Vertex3dPrinters/VERTEX-XL/README.md

# VertexXL
VertexXL printed parts

In this repository you will be able to find all the STL files ready to print and STEP files
