Vertex3dPrinters/VERTEX-XL/STEP/ELECTRONICS/XL PCB.png

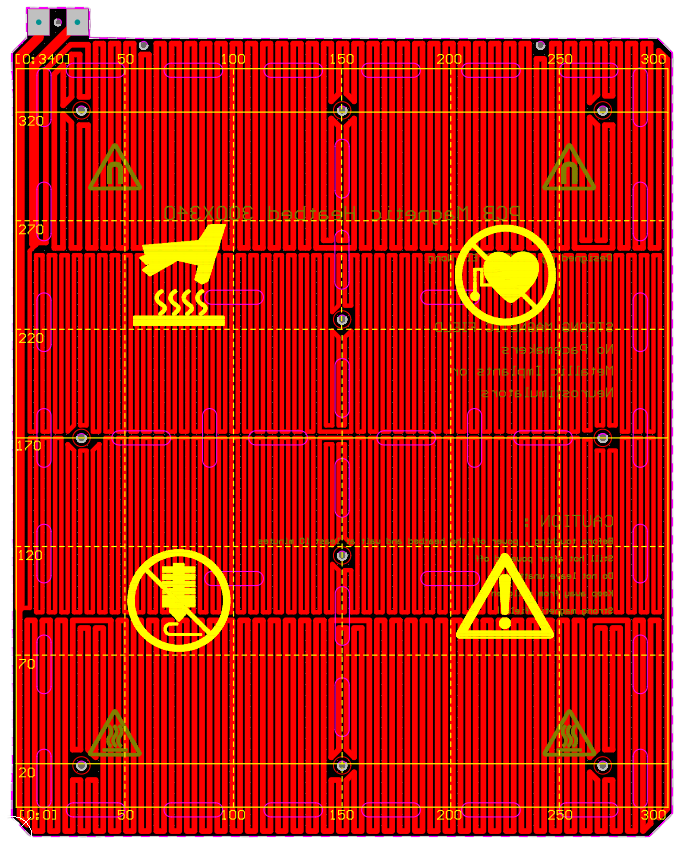
STEP/ELECTRONICS/XL PCB.png
