Vertex3dPrinters/VERTEX-XL/STL/LCD/MMU VERSION/LCD_cover_main_color.stl

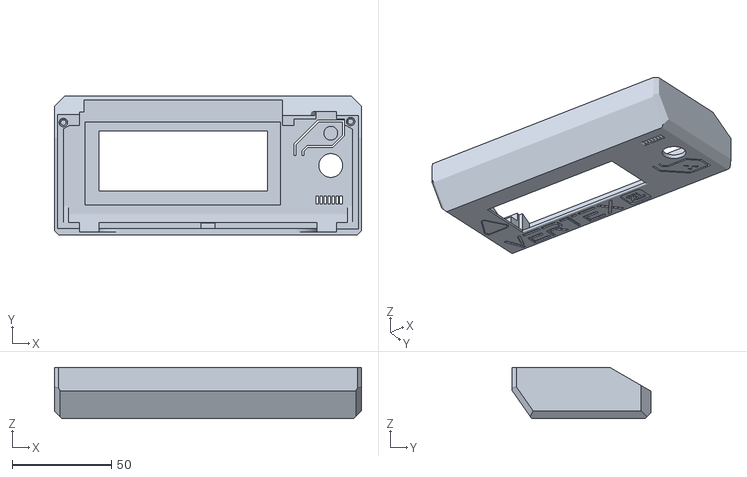
[picture p2: CAD file, 2021-08-20]
STL/LCD/MMU VERSION/LCD_cover_main_color.stl
155.0 x 70.0 x 26.0
