Vertex3dPrinters/VERTEX-XL/PS model/STL/xl_bed.stl

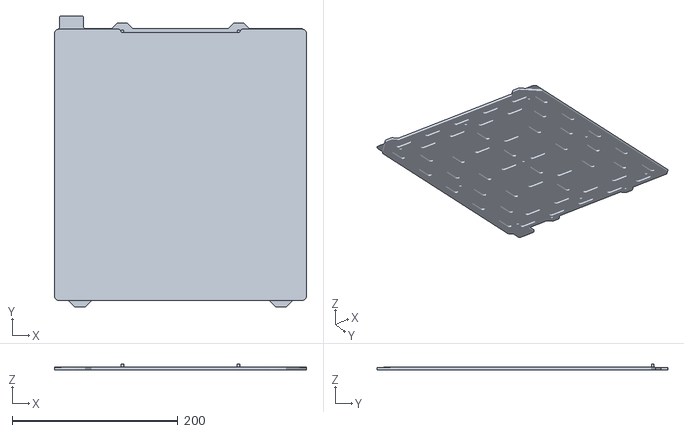
[picture p3: CAD file, 2022-12-13]
PS model/STL/xl_bed.stl
304.0 x 351.0 x 7.00
