Vertex3dPrinters/VERTEX-XL/STEP/ACCESORIES/ALUMINIUM_PROFILES.step

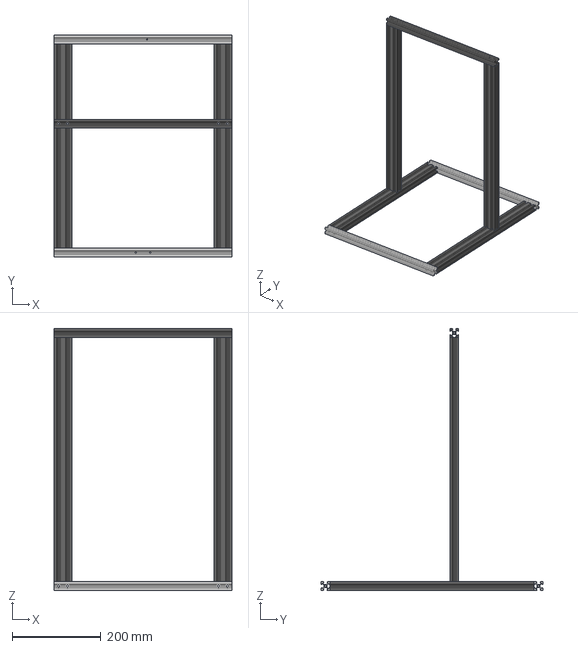
[picture p4: CAD file, 2021-09-25]
STEP/ACCESORIES/ALUMINIUM_PROFILES.step
400.0 x 500.0 x 590.0 mm
