Vertex3dPrinters/VERTEX-XL/STEP/ELECTRONICS/LCD_SINGLE.step

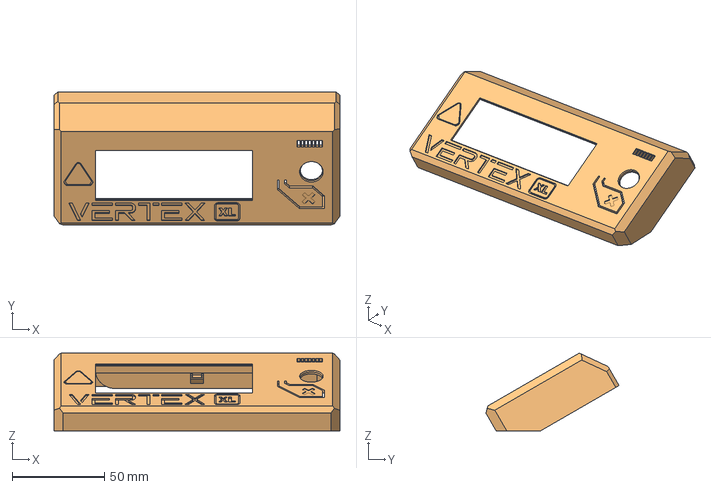
[picture p5: CAD file, 2021-09-25]
STEP/ELECTRONICS/LCD_SINGLE.step
155.0 x 72.2 x 42.2 mm
