Vertex3dPrinters/VERTEX-XL/STEP/X AXIS/EXTRUDERS/extruder-body.step

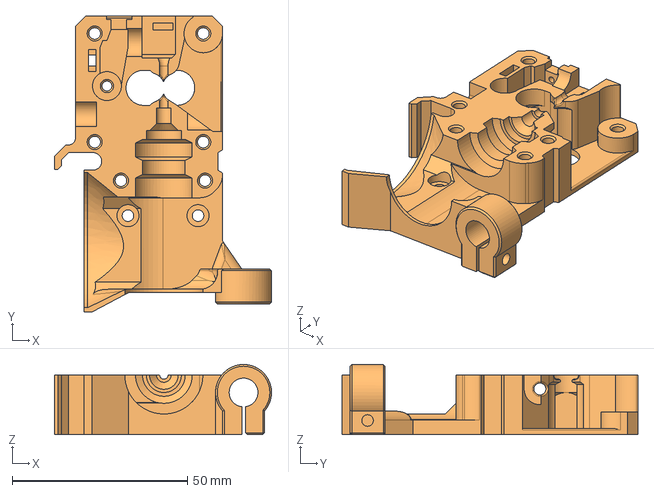
[picture p6: CAD file, 2021-09-27]
STEP/X AXIS/EXTRUDERS/extruder-body.step
62.0 x 84.5 x 20.0 mm
