Vertex3dPrinters/VERTEX-XL/STEP/X AXIS/X AXIS PARTS/X_end_motor_idler.step

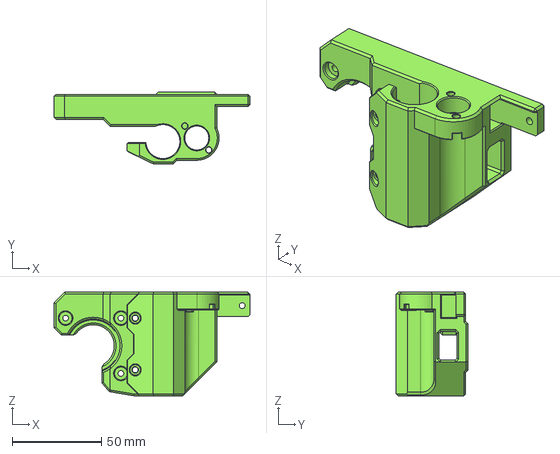
[picture p7: CAD file, 2021-09-25]
STEP/X AXIS/X AXIS PARTS/X_end_motor_idler.step
109.8 x 40.2 x 58.0 mm
