Vertex3dPrinters/VERTEX-XL/STEP/Y AXIS/Y_LINEAR_RODS_HOLDERS.step

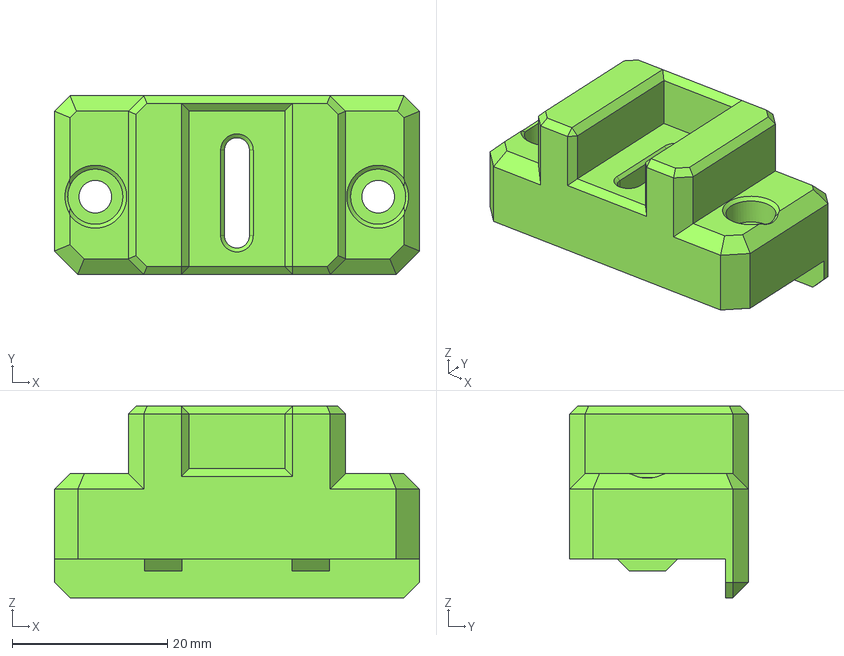
[picture p8: CAD file, 2022-01-14]
STEP/Y AXIS/Y_LINEAR_RODS_HOLDERS.step
47.0 x 23.0 x 24.7 mm
