Vertex3dPrinters/VERTEX-XL/STEP/Z AXIS/REINFORCEMENTS/Z_TOP_REINFORCEMENTS.step

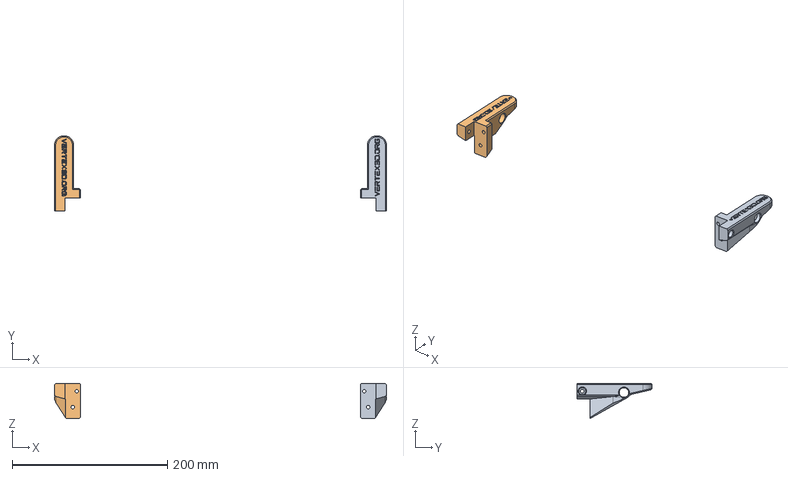
[picture p9: CAD file, 2021-09-25]
STEP/Z AXIS/REINFORCEMENTS/Z_TOP_REINFORCEMENTS.step
427.3 x 97.0 x 45.2 mm
