Vertex3dPrinters/VERTEX-XL/STEP/Z AXIS/Z_SUPPORT.step

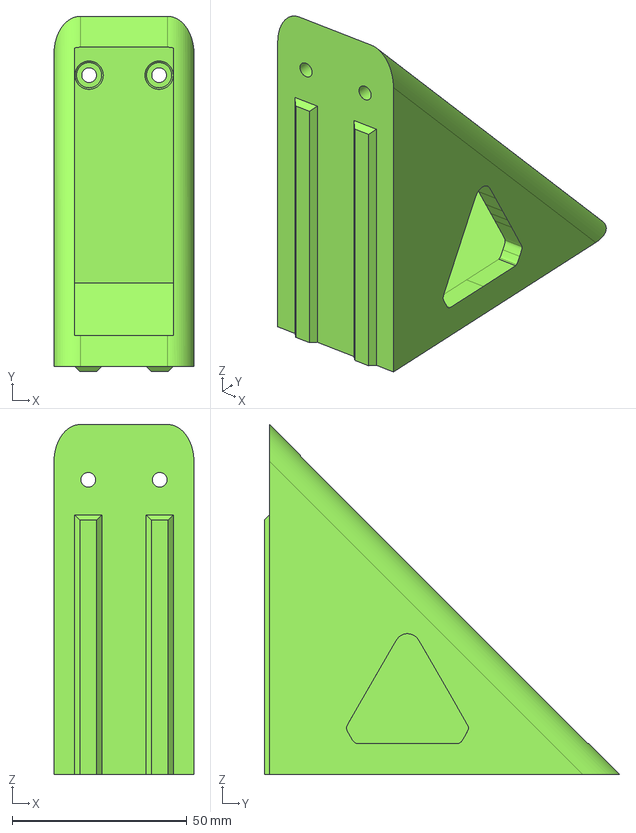
[picture p10: CAD file, 2021-09-25]
STEP/Z AXIS/Z_SUPPORT.step
40.0 x 101.5 x 100.0 mm
