Vertex3dPrinters/VERTEX-XL/STL/ACCESORIES/fs_plug_aligner.stl

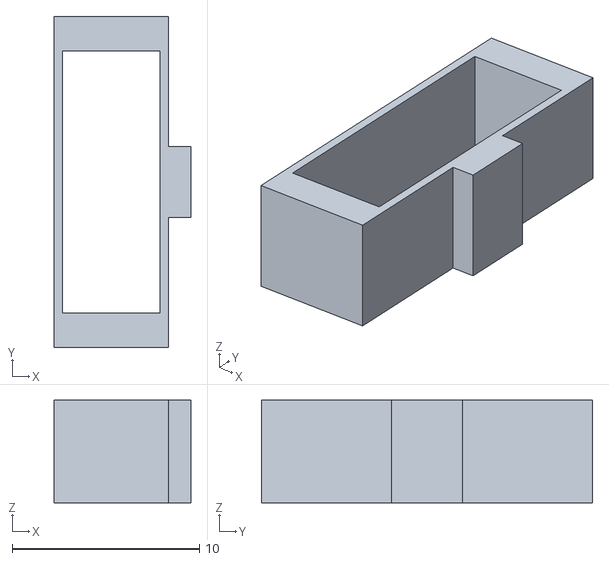
[picture p11: CAD file, 2022-02-14]
STL/ACCESORIES/fs_plug_aligner.stl
7.30 x 17.7 x 5.50
