Vertex3dPrinters/VERTEX-XL/STL/LCD/LCD_Support B.stl

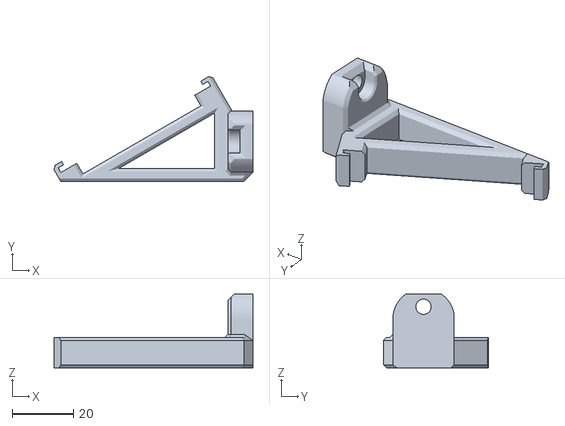
[picture p12: CAD file, 2022-01-25]
STL/LCD/LCD_Support B.stl
65.0 x 34.3 x 24.2
