Vertex3dPrinters/VERTEX-XL/STL/LCD/MMU VERSION/LCD_cover_second_color.stl

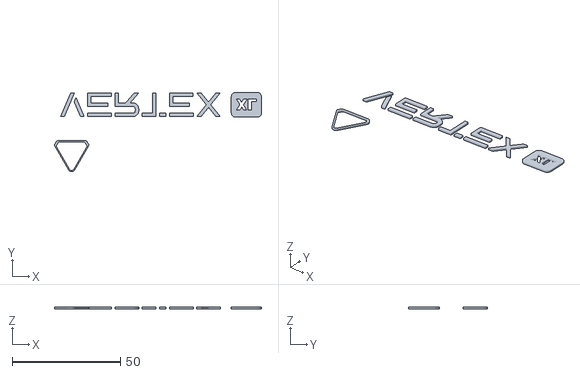
[picture p13: CAD file, 2021-08-20]
STL/LCD/MMU VERSION/LCD_cover_second_color.stl
95.5 x 36.6 x 0.8
