Vertex3dPrinters/VERTEX-XL/STL/X AXIS/EXTRUDERS/VERTEX XL MMU2S+/MMU VERTEX Triangle/COLOR-2.stl

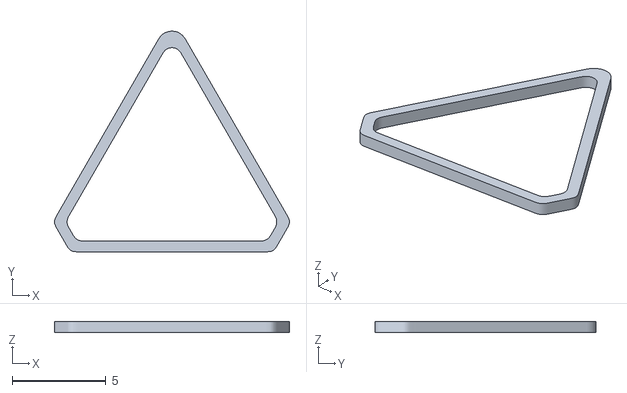
[picture p14: CAD file, 2021-05-24]
STL/X AXIS/EXTRUDERS/VERTEX XL MMU2S+/MMU VERTEX Triangle/COLOR-2.stl
12.5 x 11.8 x 0.594
