Vertex3dPrinters/VERTEX-XL/STL/X AXIS/EXTRUDERS/VERTEX XL MMU2S+/MOD-fs-cover-M10.stl

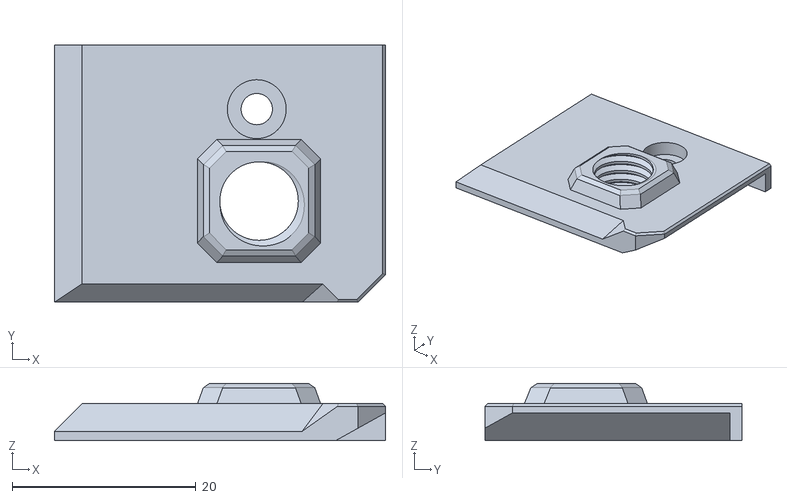
[picture p15: CAD file, 2021-05-24]
STL/X AXIS/EXTRUDERS/VERTEX XL MMU2S+/MOD-fs-cover-M10.stl
36.0 x 28.0 x 6.20
