Vertex3dPrinters/VERTEX-XL/STL/X AXIS/X AXIS PARTS/VERTEX XL linear rail1/X_end_motor_idler v2.3.stl

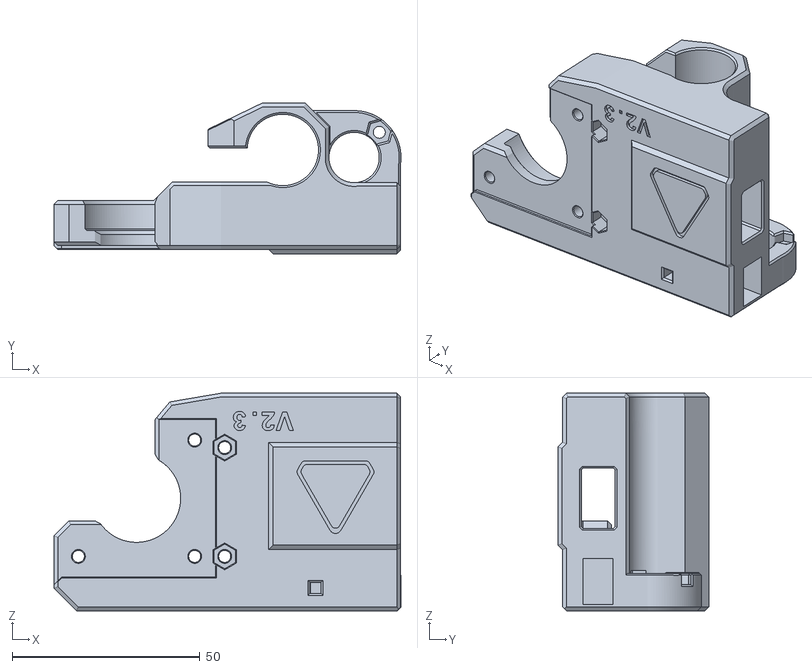
[picture p16: CAD file, 2021-04-14]
STL/X AXIS/X AXIS PARTS/VERTEX XL linear rail1/X_end_motor_idler v2.3.stl
92.5 x 40.2 x 58.0
