Vertex3dPrinters/VERTEX-XL/STL/Y AXIS/Y_belt_holder.stl

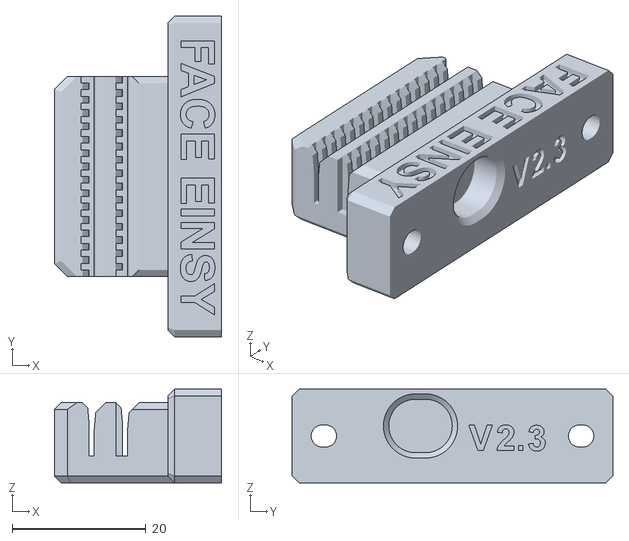
[picture p17: CAD file, 2022-03-16]
STL/Y AXIS/Y_belt_holder.stl
25.0 x 48.0 x 14.0
