Vertex3dPrinters/VERTEX-XL/STL/Z AXIS/Meanwell LRS 350W PSU/PSU_top_holder_pin.stl

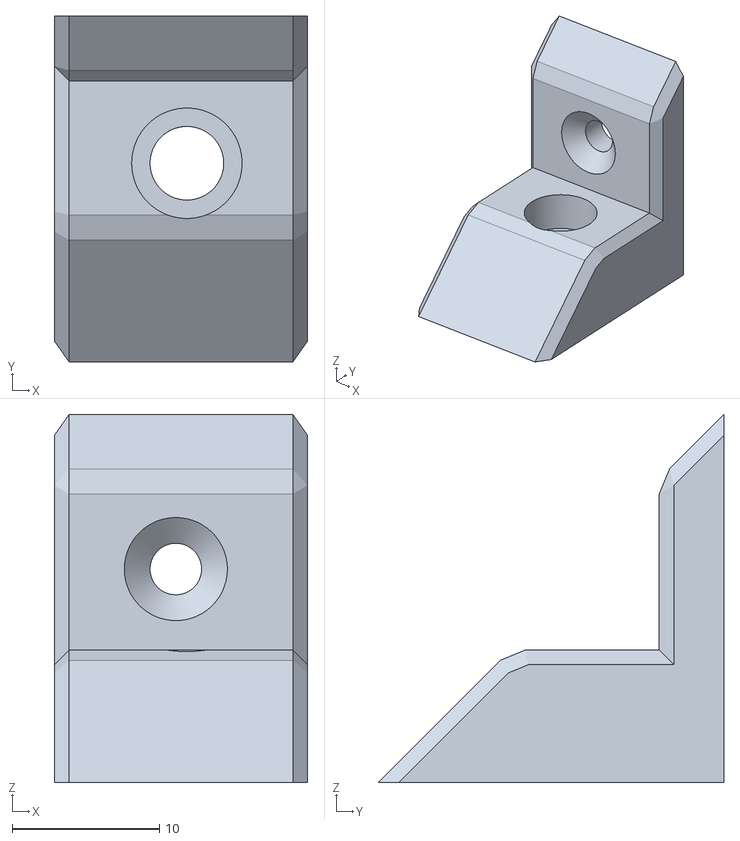
[picture p18: CAD file, 2022-02-24]
STL/Z AXIS/Meanwell LRS 350W PSU/PSU_top_holder_pin.stl
17.2 x 23.5 x 25.0
