Vertex3dPrinters/VERTEX-XL/STL/Z AXIS/RAMBO motherboard/MMU VERSION/Rambo_cover.stl

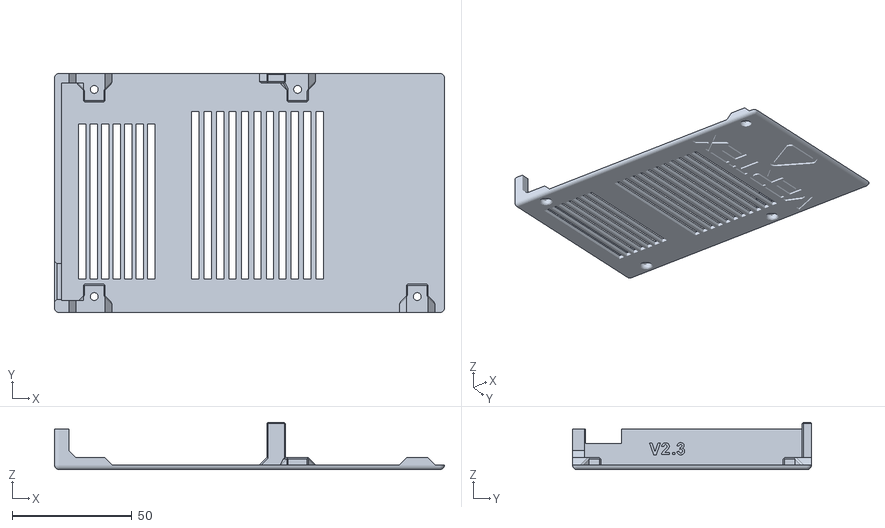
[picture p19: CAD file, 2021-07-26]
STL/Z AXIS/RAMBO motherboard/MMU VERSION/Rambo_cover.stl
163.0 x 100.0 x 19.8
