Vertex3dPrinters/VERTEX-XL/STL/Z AXIS/RAMBO motherboard/Rambo_case.stl

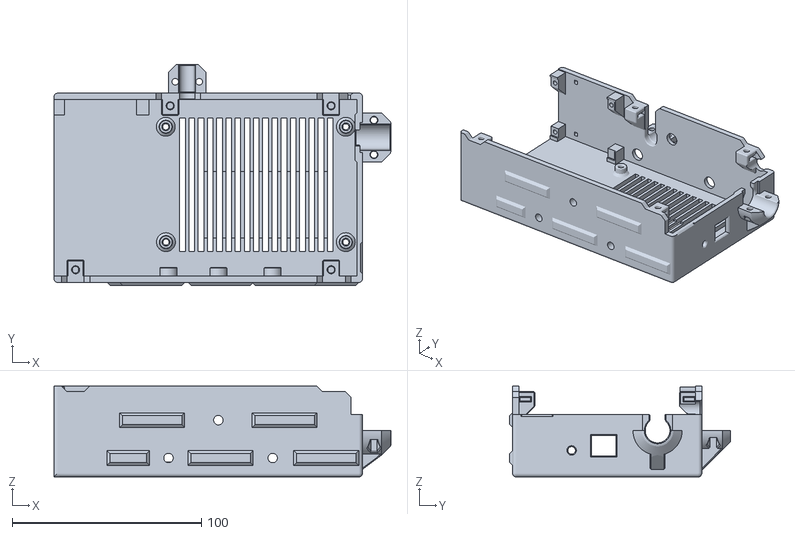
[picture p20: CAD file, 2022-03-03]
STL/Z AXIS/RAMBO motherboard/Rambo_case.stl
178.0 x 116.5 x 48.0
