Vertex3dPrinters/VERTEX-XL/STL/Z AXIS/Z REINFORCEMENT/Z_bottom_reinforcement_left.stl

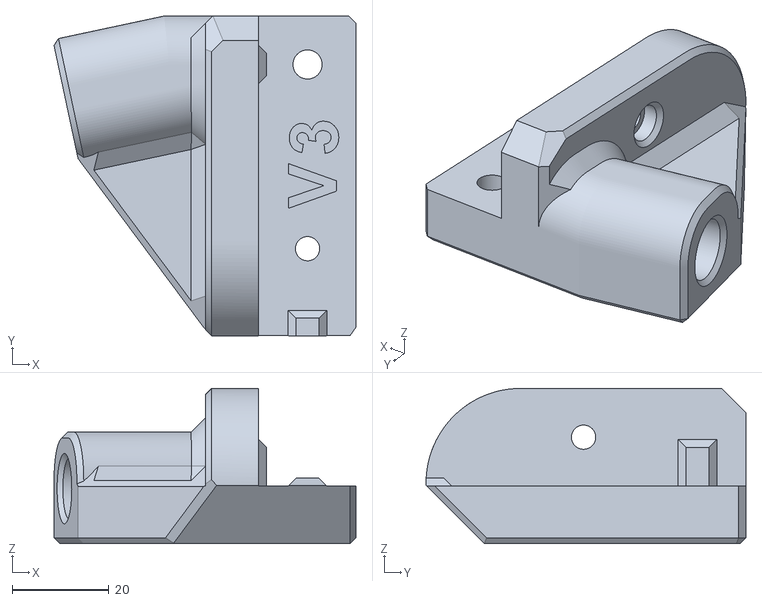
[picture p21: CAD file, 2023-03-19]
STL/Z AXIS/Z REINFORCEMENT/Z_bottom_reinforcement_left.stl
62.3 x 66.0 x 32.0
