Vertex3dPrinters/VERTEX-XL/STL/Z AXIS/Z_motor_holder_right.stl

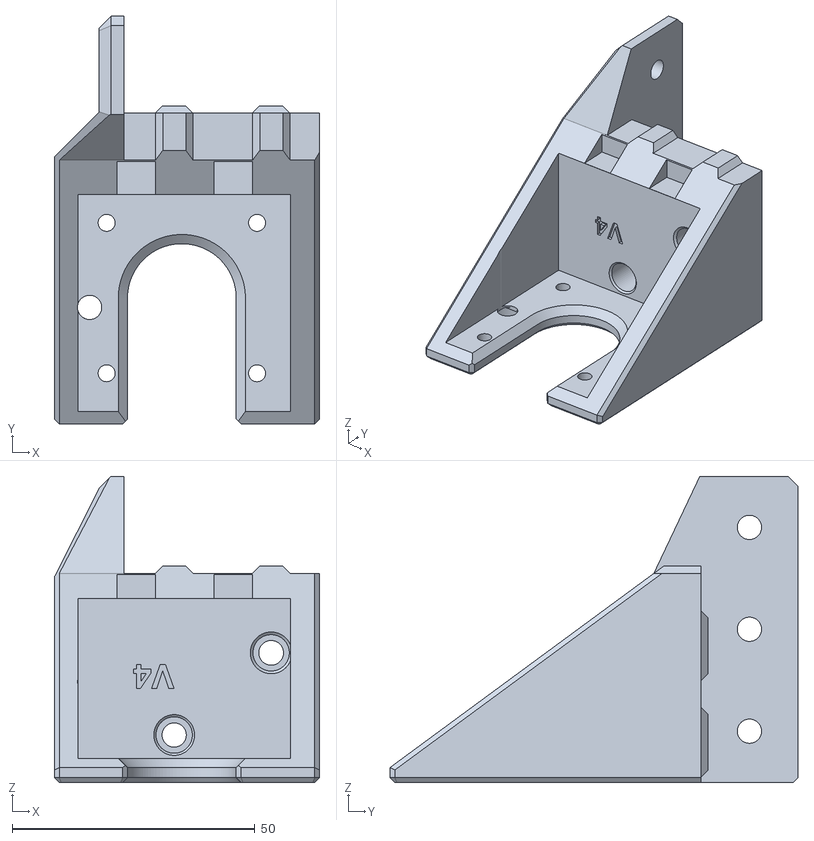
[picture p22: CAD file, 2022-01-25]
STL/Z AXIS/Z_motor_holder_right.stl
54.6 x 84.1 x 63.1
