Vertex3dPrinters/VERTEX-XL/STEP/ACCESORIES/RUBBER_FEET.step

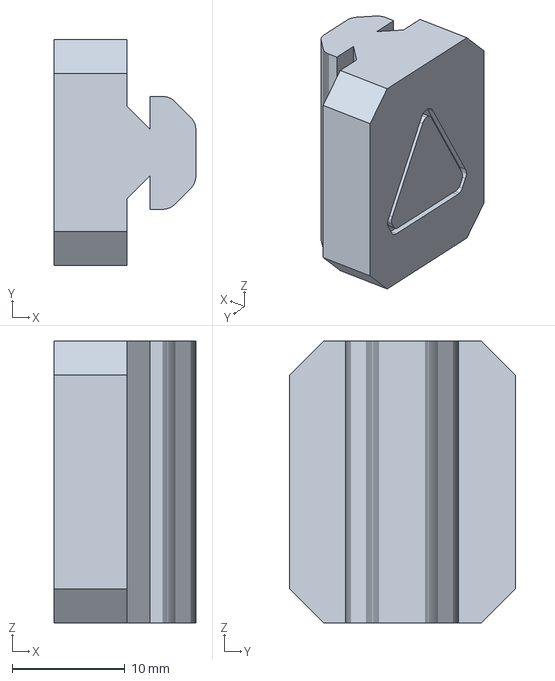
[picture p23: CAD file, 2021-09-25]
STEP/ACCESORIES/RUBBER_FEET.step
12.6 x 20.0 x 25.0 mm
