Vertex3dPrinters/VERTEX-XL/STEP/ELECTRONICS/PSU.step

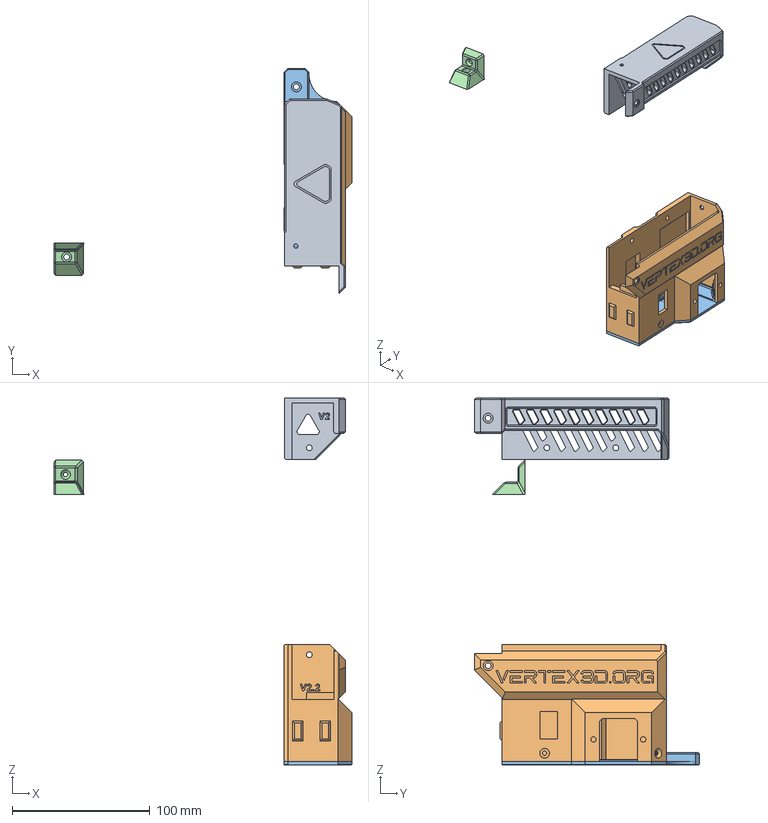
[picture p24: CAD file, 2021-09-25]
STEP/ELECTRONICS/PSU.step
215.7 x 163.3 x 266.0 mm
TopMount
CoverBody V2.1
CoverBottom
TopMount right screw
