Vertex3dPrinters/VERTEX-XL/STEP/X AXIS/EXTRUDERS/fs-cover.step

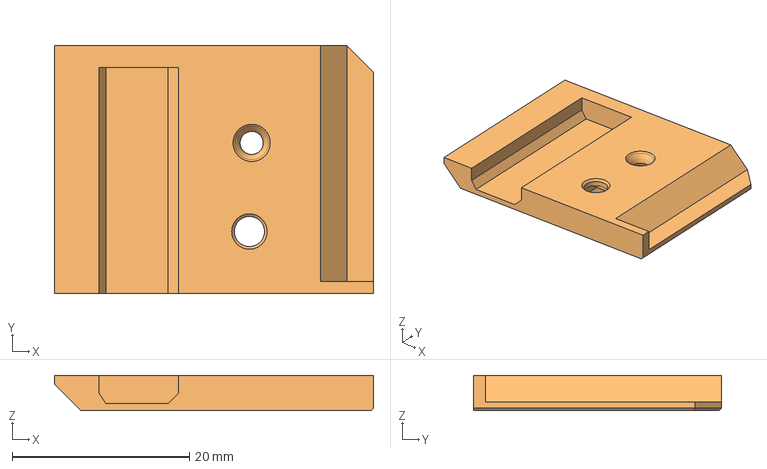
[picture p25: CAD file, 2021-09-25]
STEP/X AXIS/EXTRUDERS/fs-cover.step
36.0 x 28.0 x 4.00 mm
