Vertex3dPrinters/VERTEX-XL/STEP/X AXIS/X AXIS PARTS/X_end_idler.step

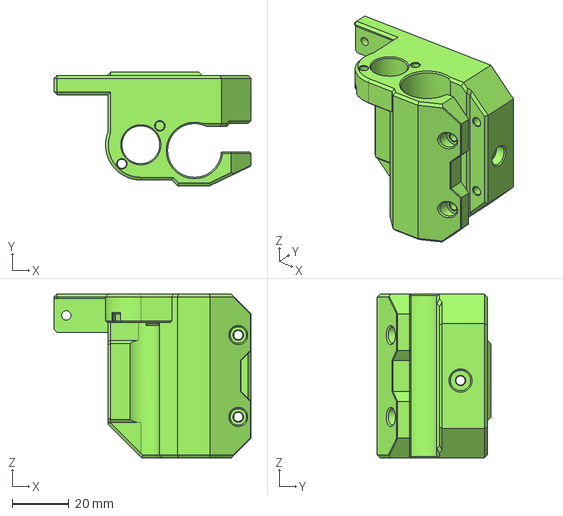
[picture p26: CAD file, 2021-09-25]
STEP/X AXIS/X AXIS PARTS/X_end_idler.step
69.7 x 40.2 x 58.0 mm
