Vertex3dPrinters/VERTEX-XL/STEP/Y AXIS/300x320mm HEATBED.step

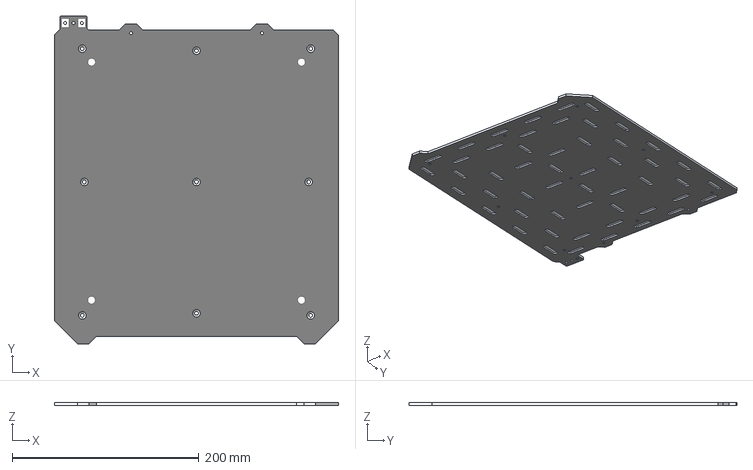
[picture p27: CAD file, 2021-11-21]
STEP/Y AXIS/300x320mm HEATBED.step
304.0 x 351.0 x 3.00 mm
