Vertex3dPrinters/VERTEX-XL/STEP/Z AXIS/REINFORCEMENTS/Z_BOTTOM_REINFORCEMENT.step

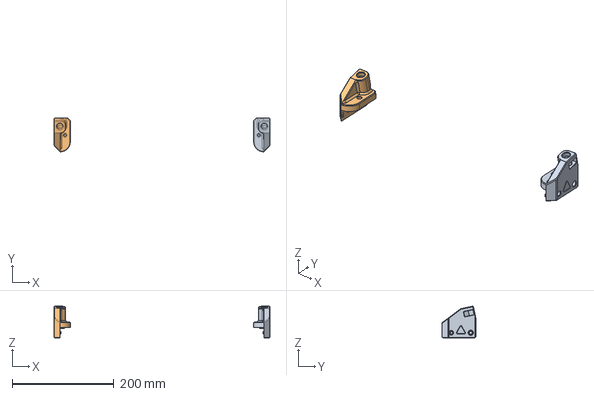
[picture p28: CAD file, 2021-09-25]
STEP/Z AXIS/REINFORCEMENTS/Z_BOTTOM_REINFORCEMENT.step
424.0 x 66.0 x 62.3 mm
