Vertex3dPrinters/VERTEX-XL/STEP/Z AXIS/Z_MOTOR_HOLDERS.step

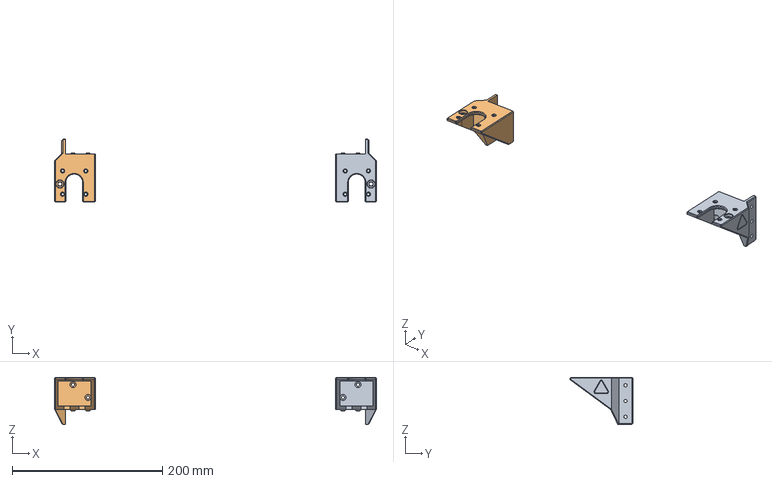
[picture p29: CAD file, 2021-09-25]
STEP/Z AXIS/Z_MOTOR_HOLDERS.step
429.3 x 84.1 x 63.1 mm
