Vertex3dPrinters/VERTEX-XL/STL/ACCESORIES/Y_linear_back_left_spacer.stl

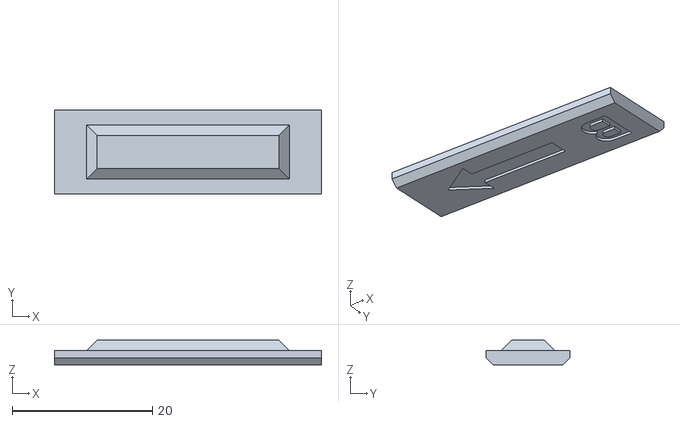
[picture p30: CAD file, 2022-01-27]
STL/ACCESORIES/Y_linear_back_left_spacer.stl
38.1 x 12.0 x 3.50
