Vertex3dPrinters/VERTEX-XL/STL/LCD/LCD_Support A.stl

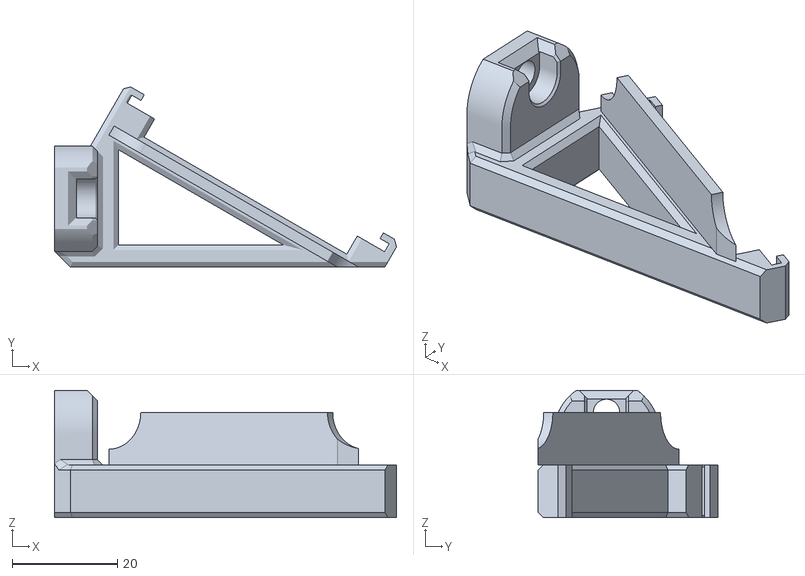
[picture p31: CAD file, 2022-01-25]
STL/LCD/LCD_Support A.stl
65.0 x 34.3 x 24.2
