Vertex3dPrinters/VERTEX-XL/STL/X AXIS/EXTRUDERS/VERTEX XL MMU2S+/MMU VERTEX Triangle/COLOR-1.stl

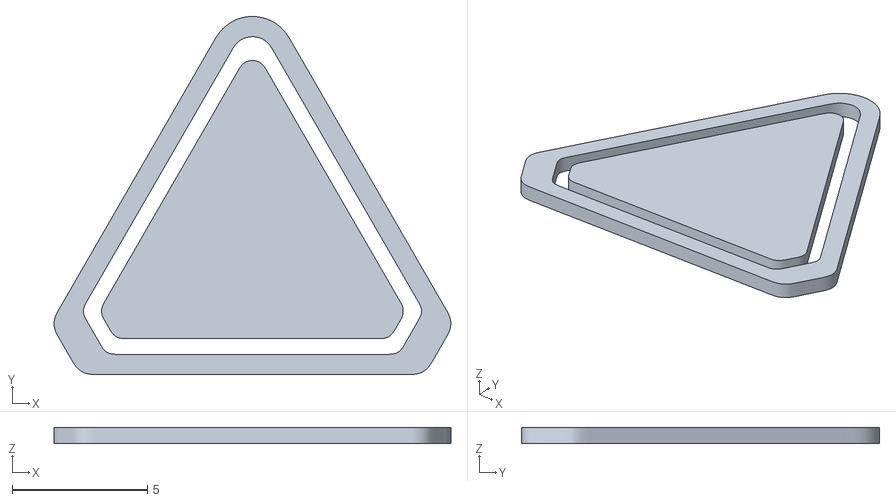
[picture p32: CAD file, 2021-05-24]
STL/X AXIS/EXTRUDERS/VERTEX XL MMU2S+/MMU VERTEX Triangle/COLOR-1.stl
14.7 x 13.2 x 0.594
