Vertex3dPrinters/VERTEX-XL/STL/X AXIS/EXTRUDERS/VERTEX XL MMU2S+/MOD-fs-cover-M6.stl

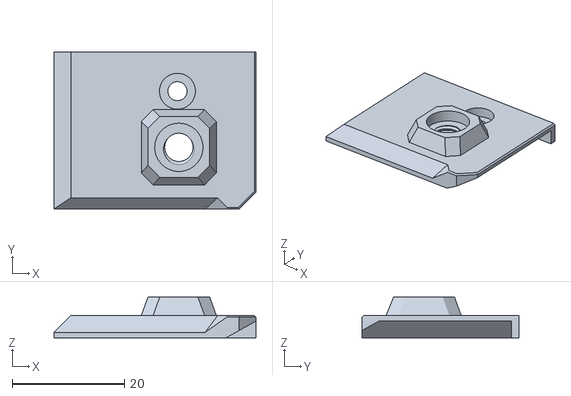
[picture p33: CAD file, 2021-05-24]
STL/X AXIS/EXTRUDERS/VERTEX XL MMU2S+/MOD-fs-cover-M6.stl
36.0 x 28.0 x 7.30
