Vertex3dPrinters/VERTEX-XL/STL/X AXIS/EXTRUDERS/VERTEX XL SINGLE/Extruder_motor_plate.stl

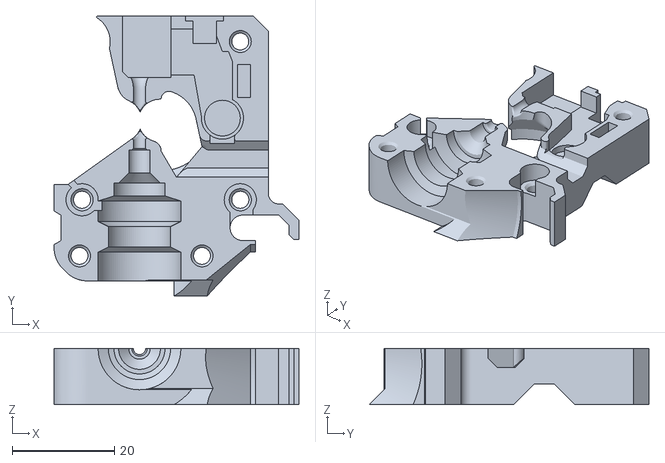
[picture p34: CAD file, 2021-09-25]
STL/X AXIS/EXTRUDERS/VERTEX XL SINGLE/Extruder_motor_plate.stl
48.0 x 54.9 x 11.0
