Vertex3dPrinters/VERTEX-XL/STL/X AXIS/X AXIS PARTS/VERTEX XL smooth rods1/X_end_tensioner v2.stl

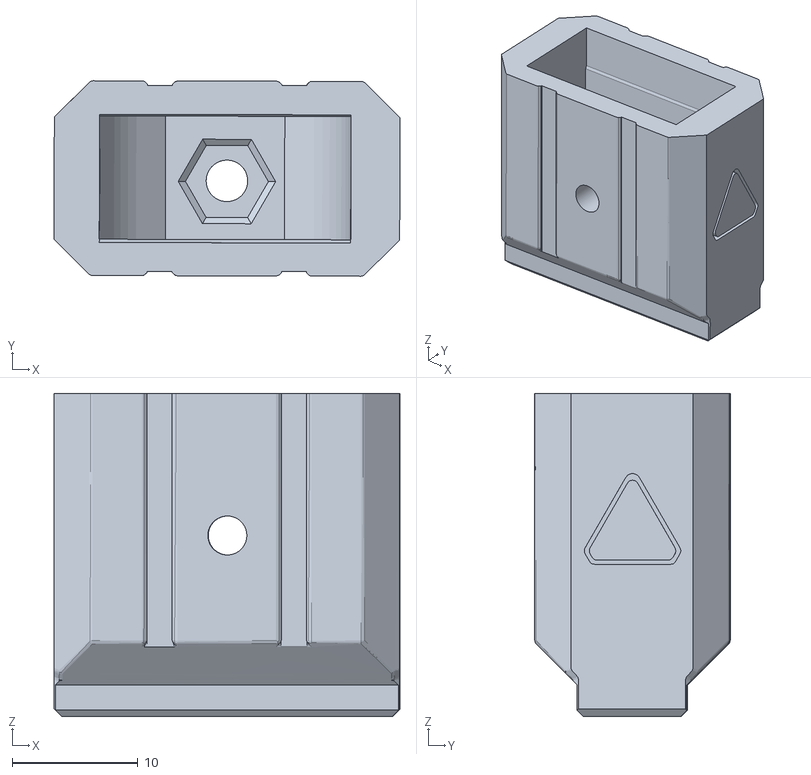
[picture p35: CAD file, 2021-01-04]
STL/X AXIS/X AXIS PARTS/VERTEX XL smooth rods1/X_end_tensioner v2.stl
27.5 x 15.6 x 25.7
