Vertex3dPrinters/VERTEX-XL/STL/Z AXIS/Meanwell LRS 350W PSU/PSU_body.stl

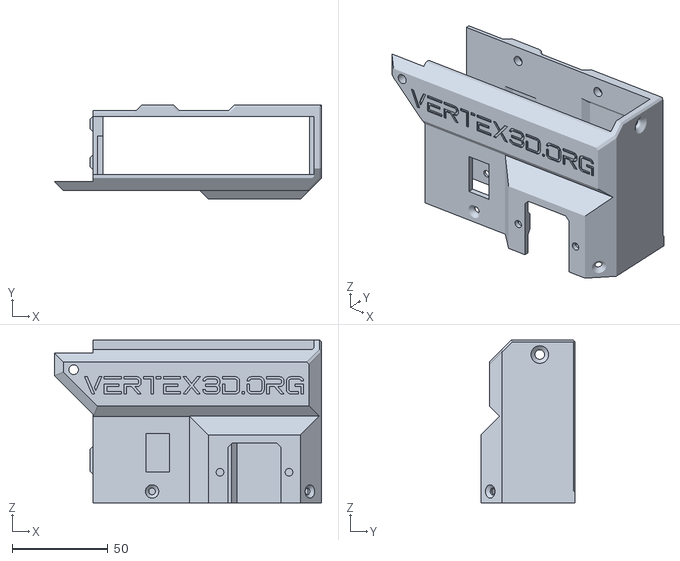
[picture p36: CAD file, 2022-01-25]
STL/Z AXIS/Meanwell LRS 350W PSU/PSU_body.stl
139.3 x 49.3 x 85.0
