Vertex3dPrinters/VERTEX-XL/STL/Z AXIS/RAMBO motherboard/MMU VERSION/Rambo_LOGO.stl

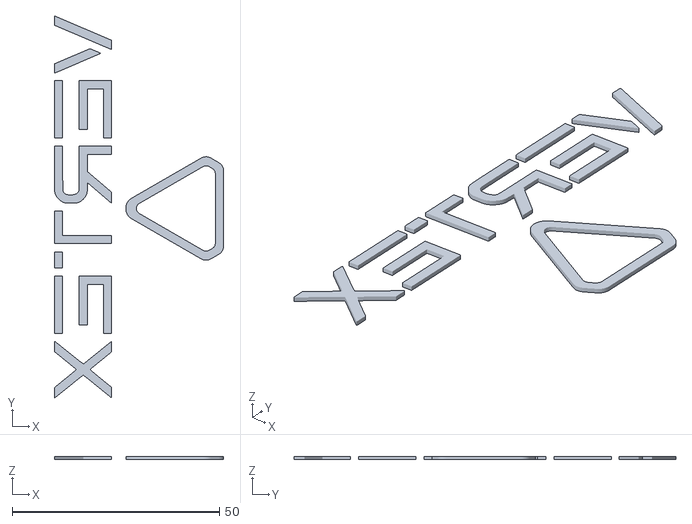
[picture p37: CAD file, 2021-02-20]
STL/Z AXIS/RAMBO motherboard/MMU VERSION/Rambo_LOGO.stl
40.9 x 92.2 x 0.8
