Vertex3dPrinters/VERTEX-XL/STEP/ACCESORIES/SPOOL_HOLDER.step

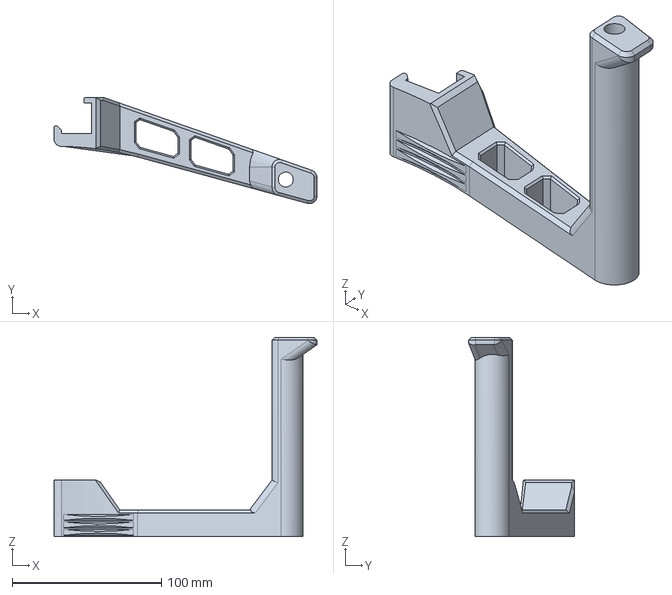
[picture p38: CAD file, 2021-09-25]
STEP/ACCESORIES/SPOOL_HOLDER.step
176.1 x 71.3 x 133.6 mm
