Vertex3dPrinters/VERTEX-XL/STEP/X AXIS/X AXIS PARTS/X_end_tensioner.step

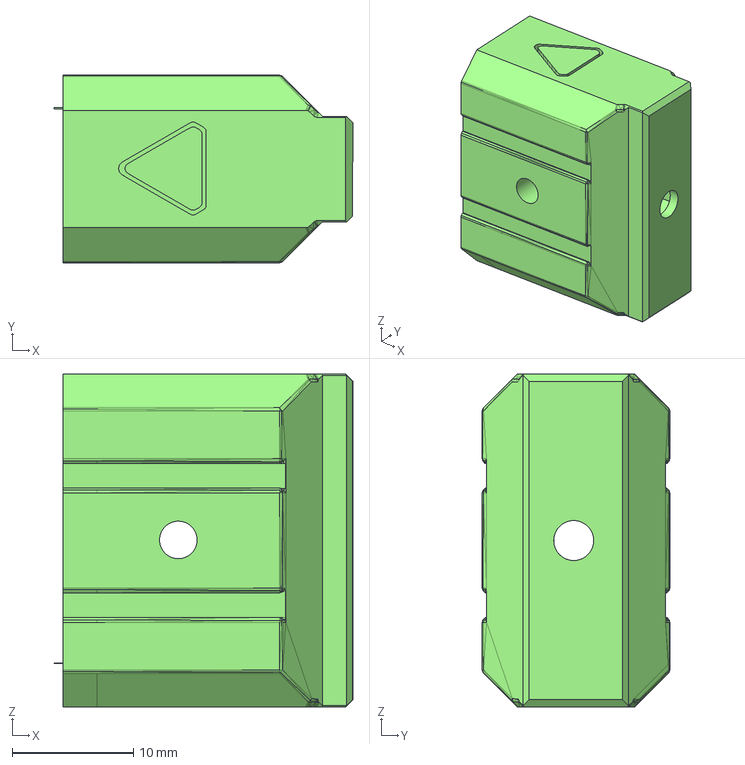
[picture p40: CAD file, 2021-09-25]
STEP/X AXIS/X AXIS PARTS/X_end_tensioner.step
24.7 x 15.5 x 27.5 mm
