Vertex3dPrinters/VERTEX-XL/STEP/Y AXIS/Y_MOTOR_HOLDER v1.step

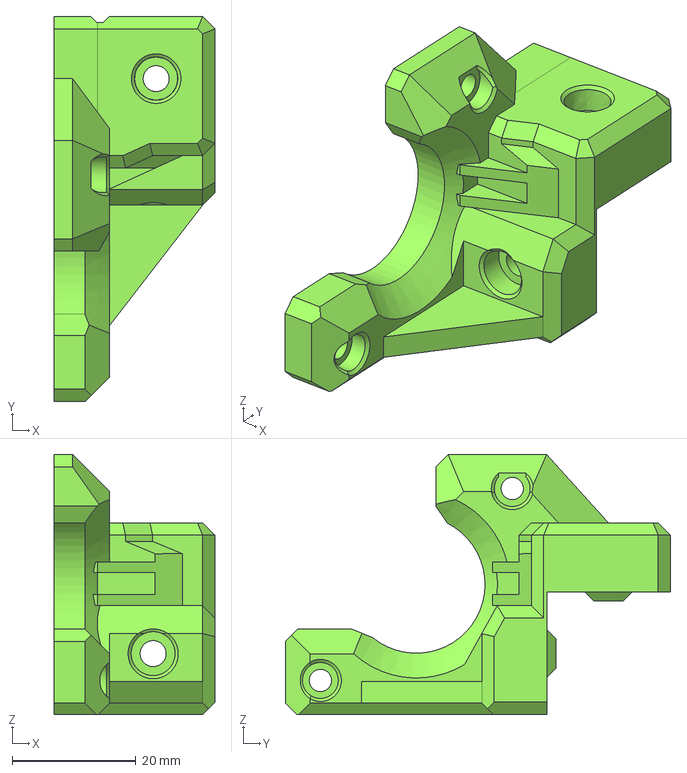
[picture p41: CAD file, 2021-09-25]
STEP/Y AXIS/Y_MOTOR_HOLDER v1.step
26.0 x 62.2 x 42.0 mm
