Vertex3dPrinters/VERTEX-XL/STEP/Z AXIS/Z_TOP_RIGHT.step

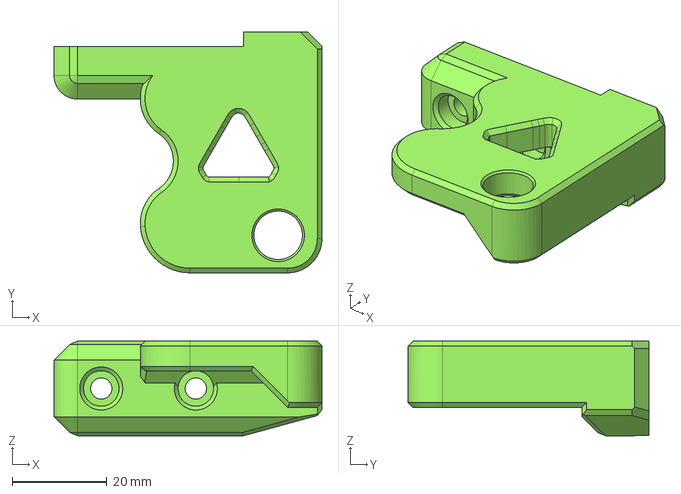
[picture p42: CAD file, 2021-09-25]
STEP/Z AXIS/Z_TOP_RIGHT.step
56.7 x 50.9 x 20.0 mm
