Vertex3dPrinters/VERTEX-XL/STL/ACCESORIES/Y_linear_back_right_spacer.stl

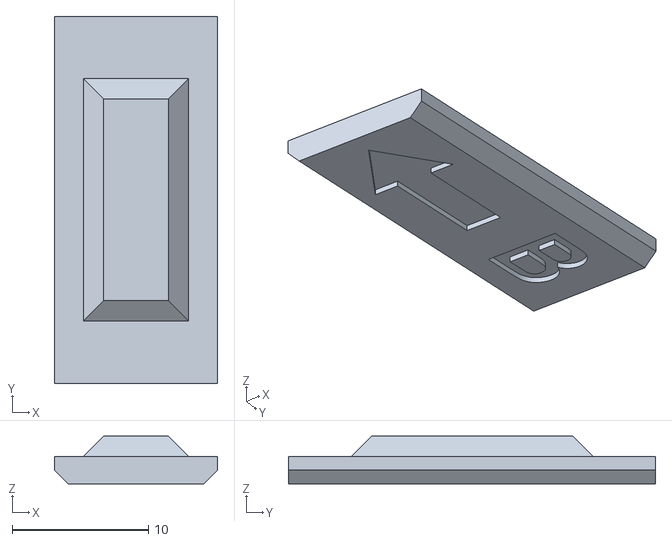
[picture p43: CAD file, 2022-01-27]
STL/ACCESORIES/Y_linear_back_right_spacer.stl
12.0 x 27.0 x 3.50
