Vertex3dPrinters/VERTEX-XL/STL/LCD/LCD_cover.stl

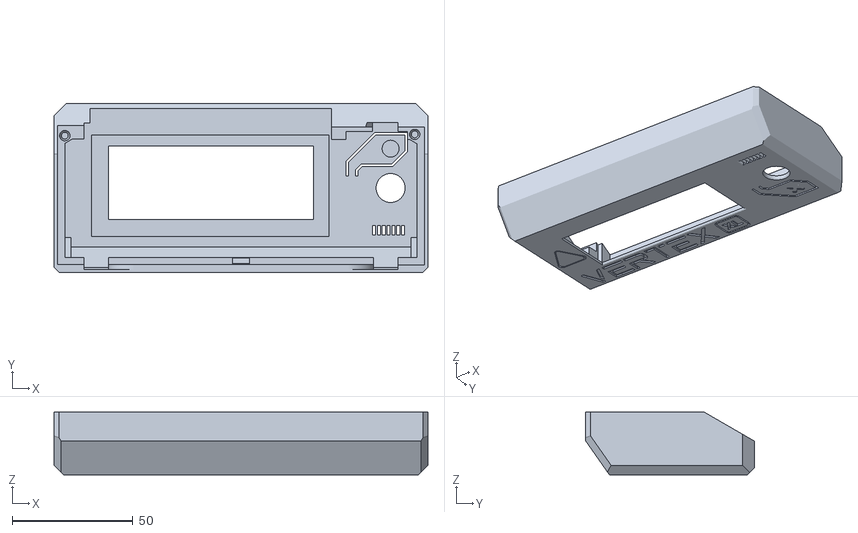
[picture p44: CAD file, 2021-08-20]
STL/LCD/LCD_cover.stl
155.0 x 70.0 x 26.0
