Vertex3dPrinters/VERTEX-XL/STL/LCD/MMU VERSION/LCD_cover_x_third_color.stl

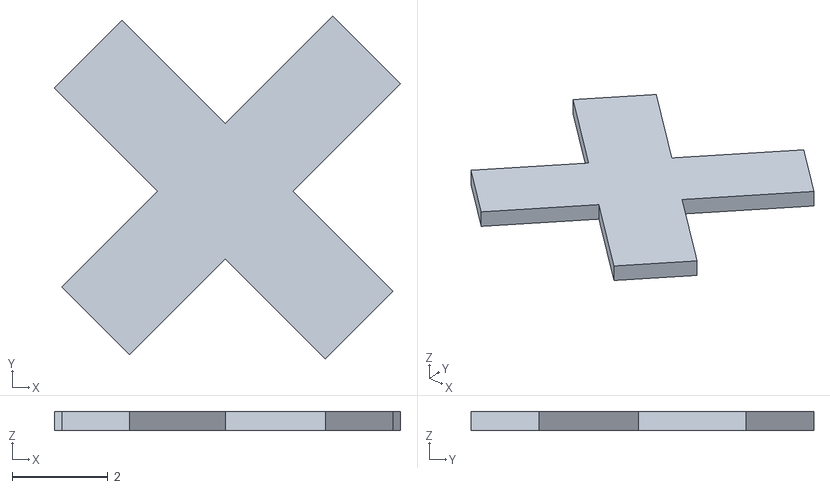
[picture p45: CAD file, 2021-08-20]
STL/LCD/MMU VERSION/LCD_cover_x_third_color.stl
7.23 x 7.16 x 0.4
