Vertex3dPrinters/VERTEX-XL/STL/X AXIS/EXTRUDERS/VERTEX XL MMU2S+/MOD-extruder-idler.stl

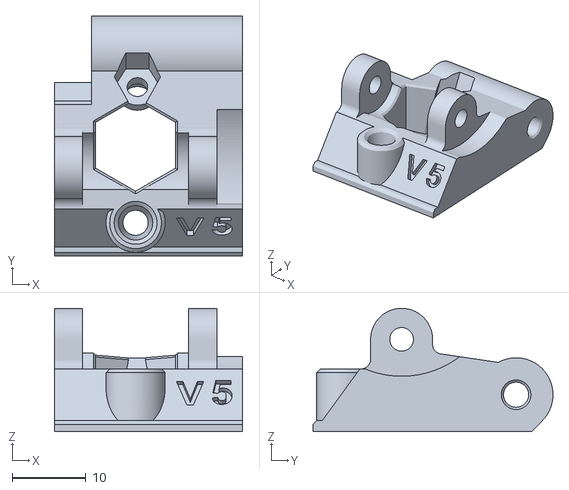
[picture p46: CAD file, 2021-05-24]
STL/X AXIS/EXTRUDERS/VERTEX XL MMU2S+/MOD-extruder-idler.stl
25.5 x 32.5 x 16.7
