Vertex3dPrinters/VERTEX-XL/STL/X AXIS/EXTRUDERS/VERTEX XL SINGLE/Extruder_adapter_printer.stl

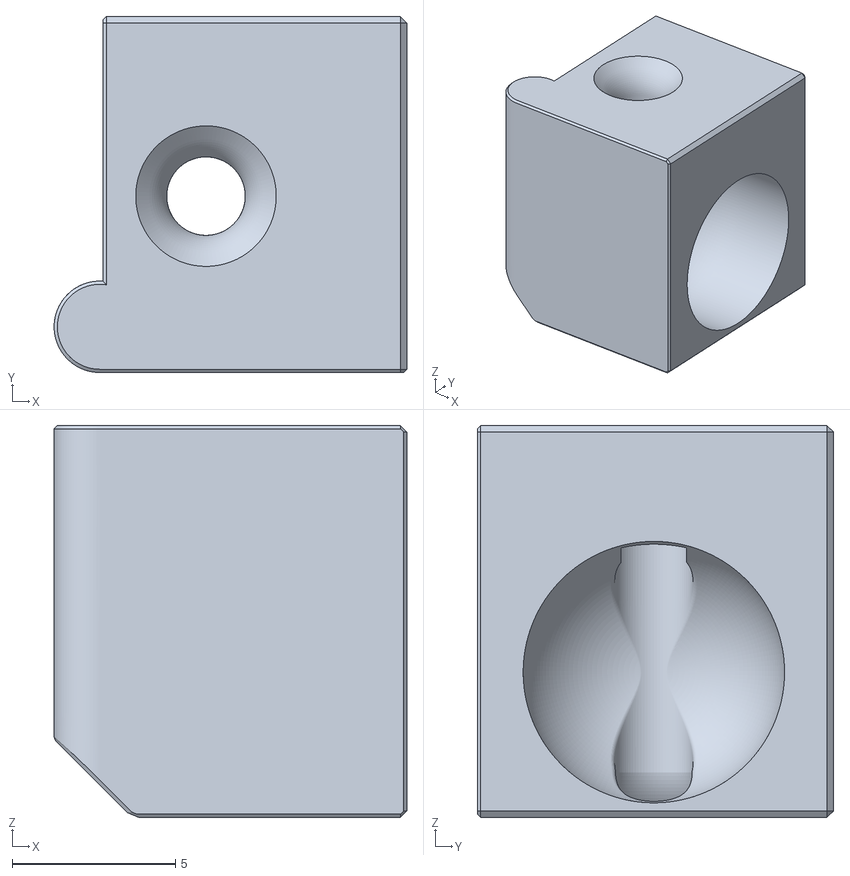
[picture p47: CAD file, 2021-09-25]
STL/X AXIS/EXTRUDERS/VERTEX XL SINGLE/Extruder_adapter_printer.stl
10.8 x 10.9 x 12.0
