Vertex3dPrinters/VERTEX-XL/STL/Y AXIS/heatbed_cable_cover_clip.stl

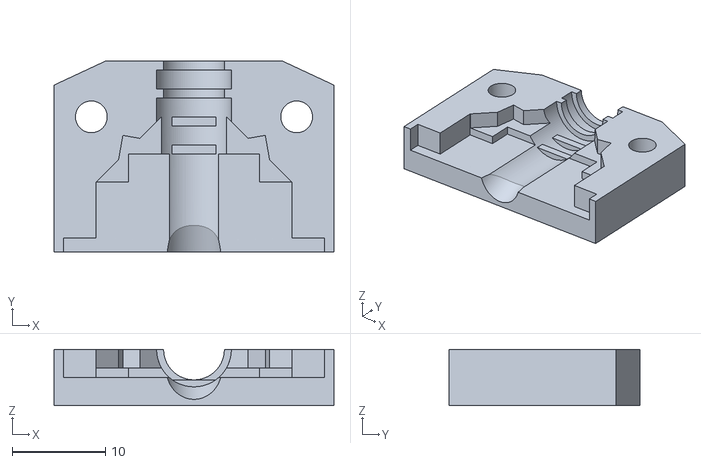
[picture p48: CAD file, 2022-01-25]
STL/Y AXIS/heatbed_cable_cover_clip.stl
30.0 x 20.5 x 6.00
