Vertex3dPrinters/VERTEX-XL/STL/Z AXIS/Meanwell LRS 350W PSU/PSU_top_holder.stl

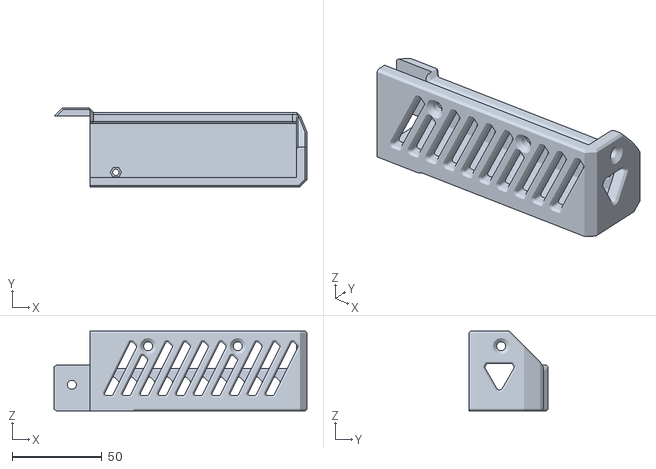
[picture p49: CAD file, 2022-01-25]
STL/Z AXIS/Meanwell LRS 350W PSU/PSU_top_holder.stl
141.1 x 44.2 x 44.6
