Vertex3dPrinters/VERTEX-XL/STL/Z AXIS/RAMBO motherboard/Extruder_cable_rambo_cover.stl

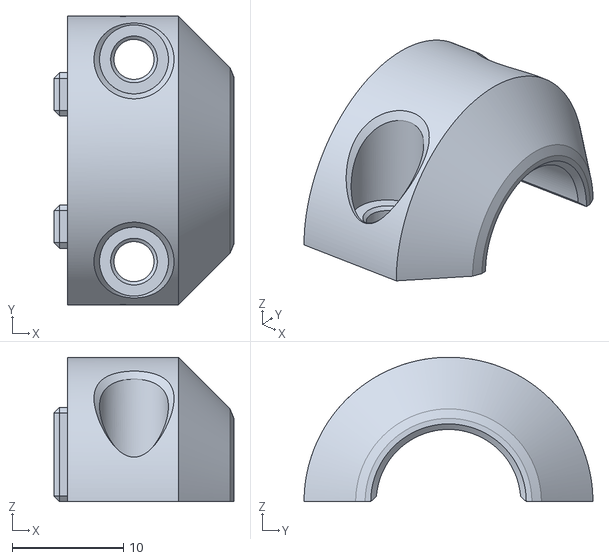
[picture p50: CAD file, 2022-01-25]
STL/Z AXIS/RAMBO motherboard/Extruder_cable_rambo_cover.stl
16.2 x 26.0 x 13.0
