Vertex3dPrinters/VERTEX-XL/STL/Z AXIS/Z REINFORCEMENT/Z_top_reinforcement_left.stl

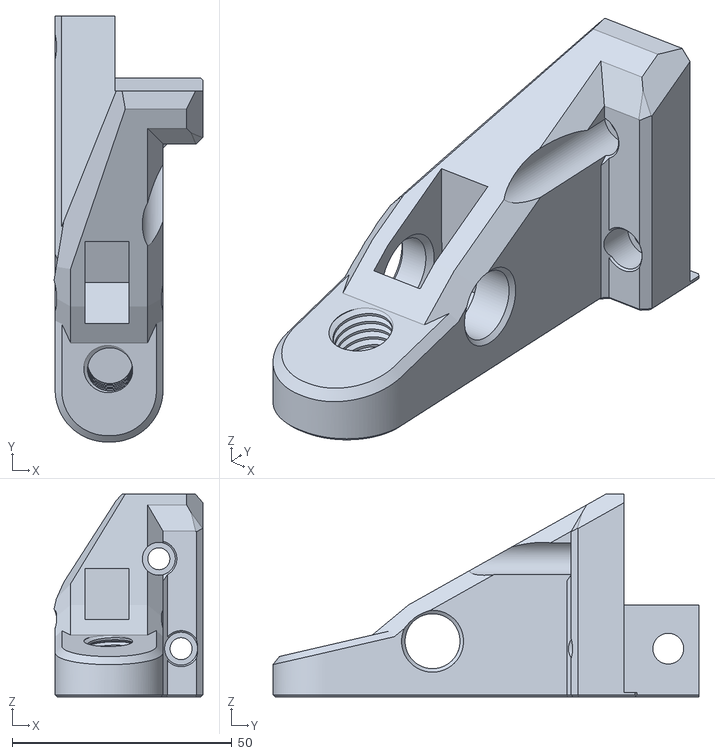
[picture p51: CAD file, 2022-06-07]
STL/Z AXIS/Z REINFORCEMENT/Z_top_reinforcement_left.stl
33.9 x 97.0 x 46.2
