Vertex3dPrinters/VERTEX-XL/STEP/ELECTRONICS/LCD_Supports.step

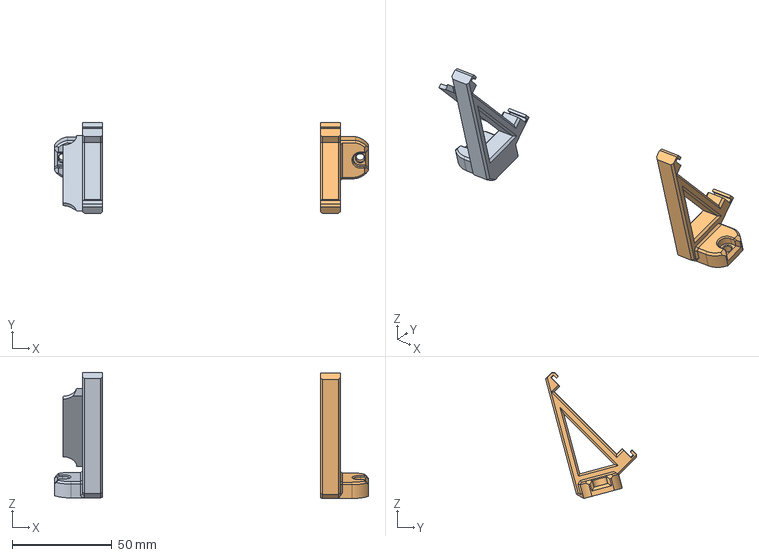
[picture p52: CAD file, 2021-09-25]
STEP/ELECTRONICS/LCD_Supports.step
157.8 x 45.6 x 63.4 mm
