Vertex3dPrinters/VERTEX-XL/STEP/X AXIS/EXTRUDERS/fs-lever.step

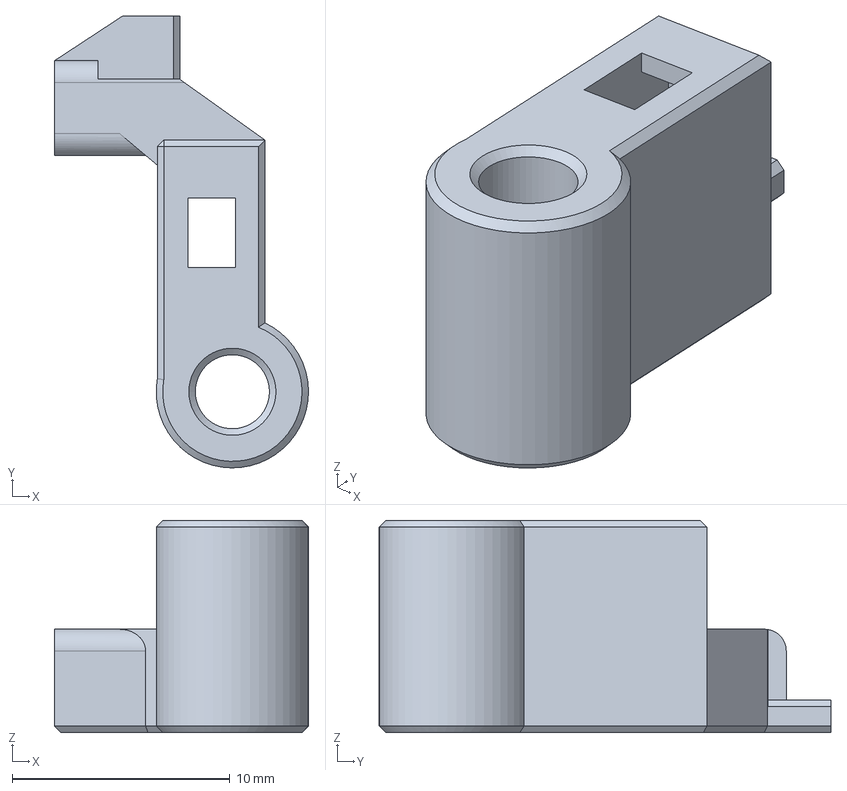
[picture p53: CAD file, 2021-09-25]
STEP/X AXIS/EXTRUDERS/fs-lever.step
11.7 x 20.8 x 9.75 mm
