Vertex3dPrinters/VERTEX-XL/STEP/Y AXIS/Y_TENSIONER v1.step

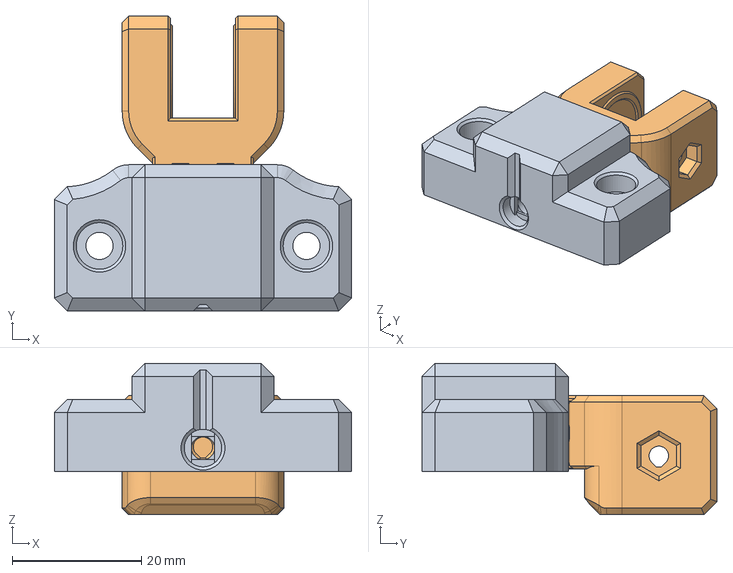
[picture p54: CAD file, 2021-09-25]
STEP/Y AXIS/Y_TENSIONER v1.step
46.0 x 45.6 x 23.4 mm
