Vertex3dPrinters/VERTEX-XL/STL/ACCESORIES/Y_linear_front_left_spacer.stl

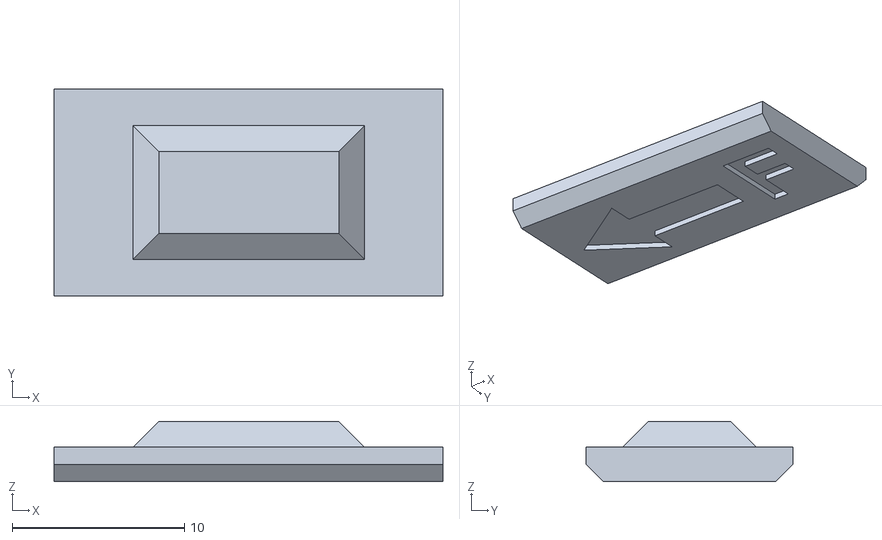
[picture p55: CAD file, 2022-01-27]
STL/ACCESORIES/Y_linear_front_left_spacer.stl
22.6 x 12.0 x 3.50
