Vertex3dPrinters/VERTEX-XL/STL/LCD/LCD_knob.stl

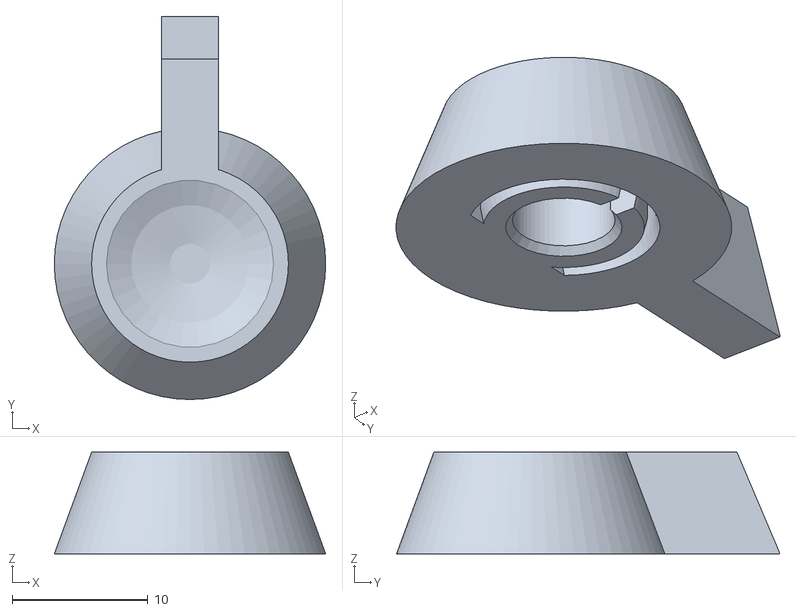
[picture p56: CAD file, 2021-04-14]
STL/LCD/LCD_knob.stl
20.0 x 28.2 x 7.50
