Vertex3dPrinters/VERTEX-XL/STL/X AXIS/EXTRUDERS/VERTEX XL SINGLE/Extruder_x_carriage_cover.stl

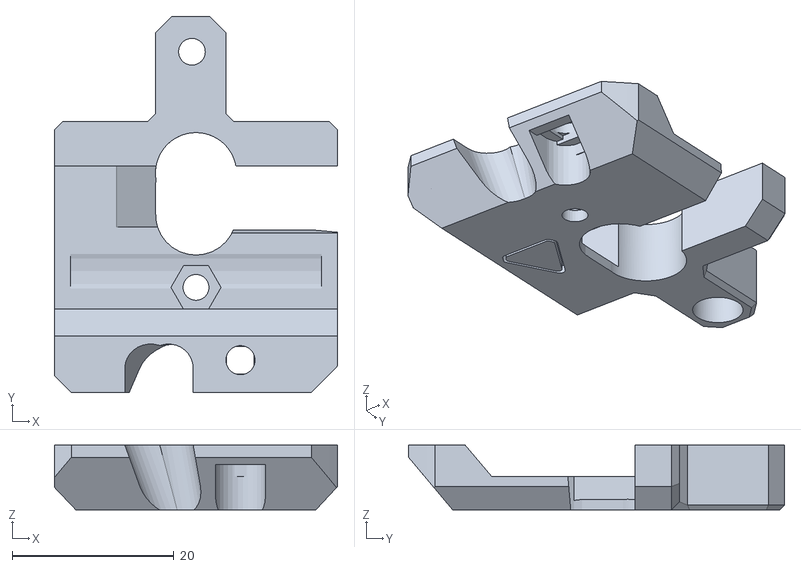
[picture p57: CAD file, 2021-08-24]
STL/X AXIS/EXTRUDERS/VERTEX XL SINGLE/Extruder_x_carriage_cover.stl
35.0 x 46.5 x 8.00
