Vertex3dPrinters/VERTEX-XL/STL/Y AXIS/heatbed_cable_cover.stl

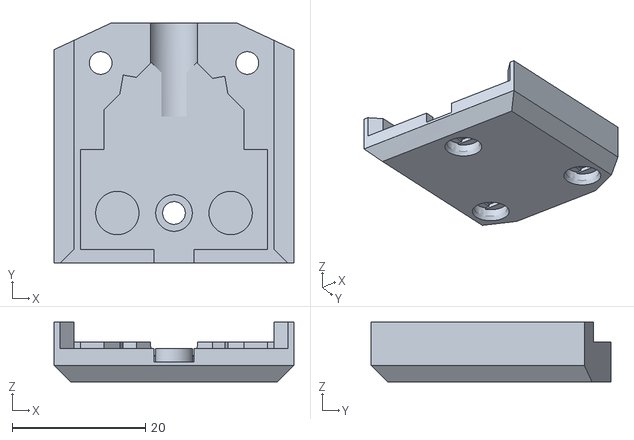
[picture p58: CAD file, 2022-01-25]
STL/Y AXIS/heatbed_cable_cover.stl
36.0 x 36.0 x 9.00
