Vertex3dPrinters/VERTEX-XL/STL/Z AXIS/Meanwell LRS 350W PSU/PSU_cover.stl

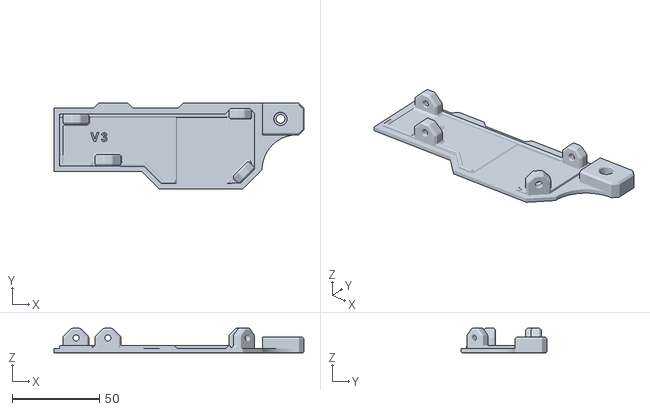
[picture p59: CAD file, 2022-01-25]
STL/Z AXIS/Meanwell LRS 350W PSU/PSU_cover.stl
143.3 x 49.3 x 14.1
