Vertex3dPrinters/VERTEX-XL/STL/Z AXIS/RAMBO motherboard/Heatbed_cable_rambo_cover.stl

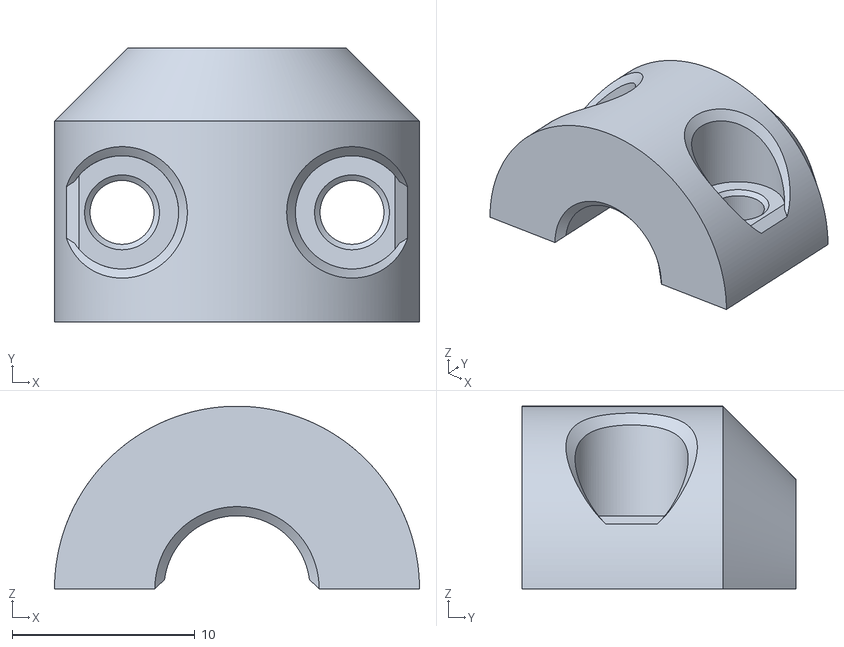
[picture p60: CAD file, 2022-01-25]
STL/Z AXIS/RAMBO motherboard/Heatbed_cable_rambo_cover.stl
20.0 x 15.0 x 10.0
