Vertex3dPrinters/VERTEX-XL/STEP/ACCESORIES/2020_corner.step

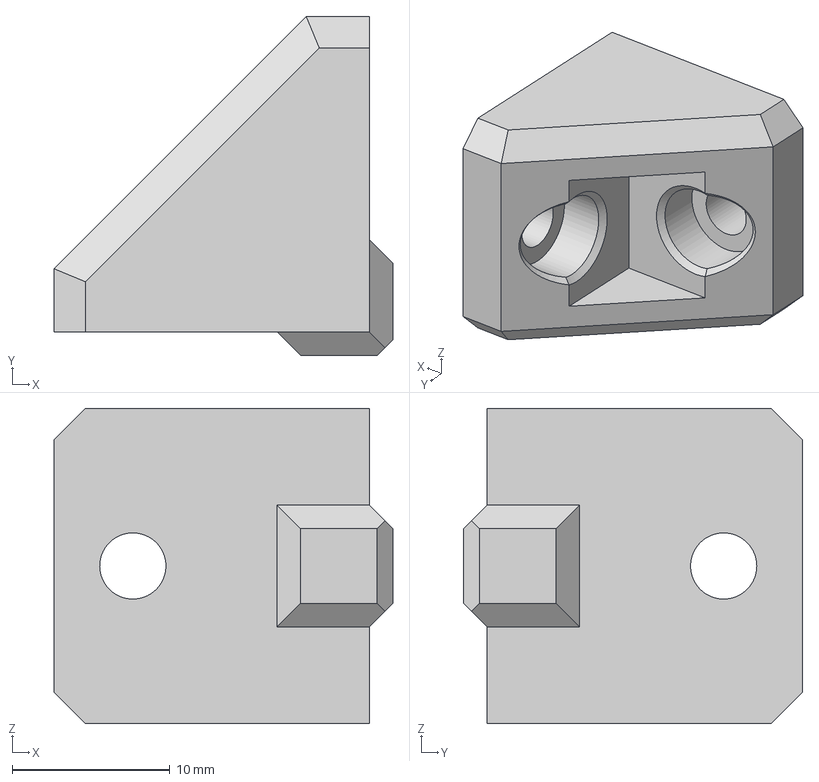
[picture p61: CAD file, 2021-05-15]
STEP/ACCESORIES/2020_corner.step
21.5 x 21.5 x 20.0 mm
