Vertex3dPrinters/VERTEX-XL/STEP/X AXIS/EXTRUDERS/print-fan-support.step

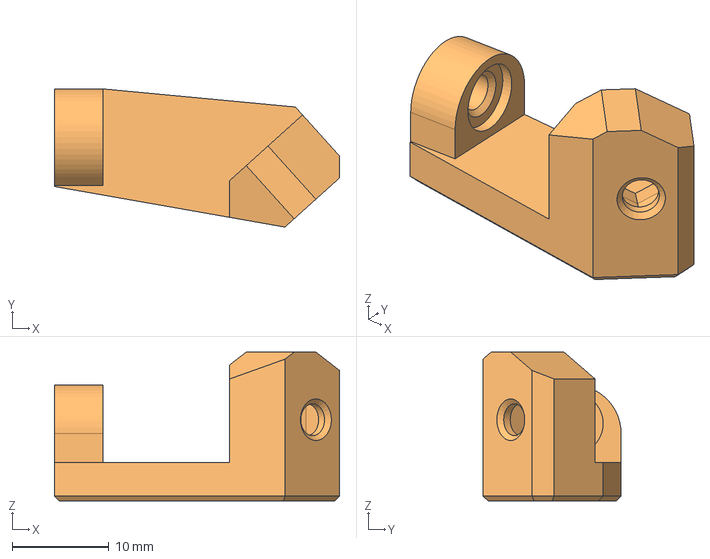
[picture p62: CAD file, 2021-09-25]
STEP/X AXIS/EXTRUDERS/print-fan-support.step
29.5 x 14.3 x 15.4 mm
