Vertex3dPrinters/VERTEX-XL/STEP/Y AXIS/Heatbed_cover.step

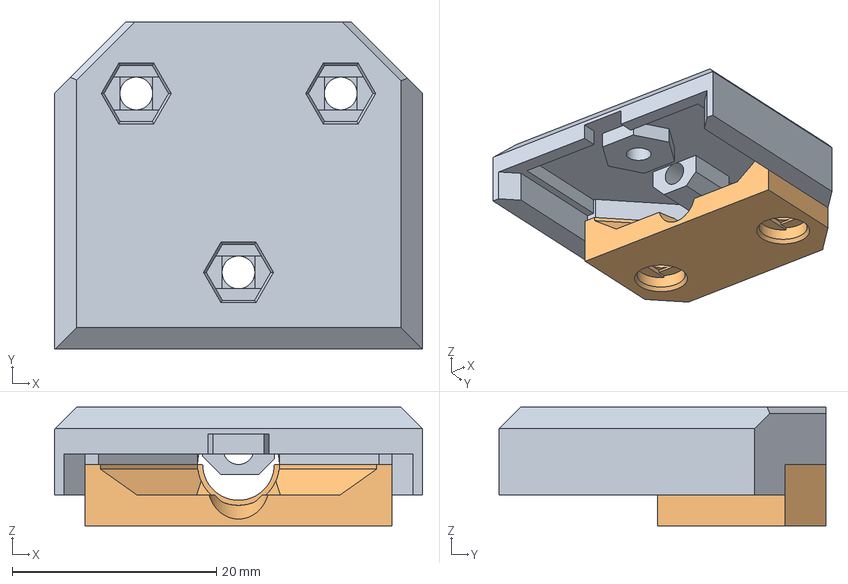
[picture p63: CAD file, 2021-09-25]
STEP/Y AXIS/Heatbed_cover.step
36.0 x 32.0 x 11.6 mm
