Vertex3dPrinters/VERTEX-XL/STL/X AXIS/EXTRUDERS/VERTEX XL MMU2S+/MOD-extruder-motor-plate.stl

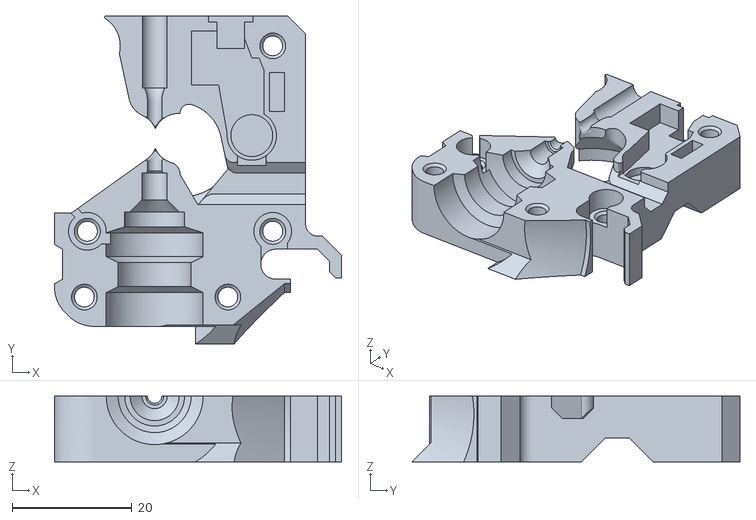
[picture p64: CAD file, 2021-04-14]
STL/X AXIS/EXTRUDERS/VERTEX XL MMU2S+/MOD-extruder-motor-plate.stl
48.0 x 54.8 x 11.0
