Vertex3dPrinters/VERTEX-XL/STL/X AXIS/EXTRUDERS/VERTEX XL SINGLE/Extruder_x_carriage.stl

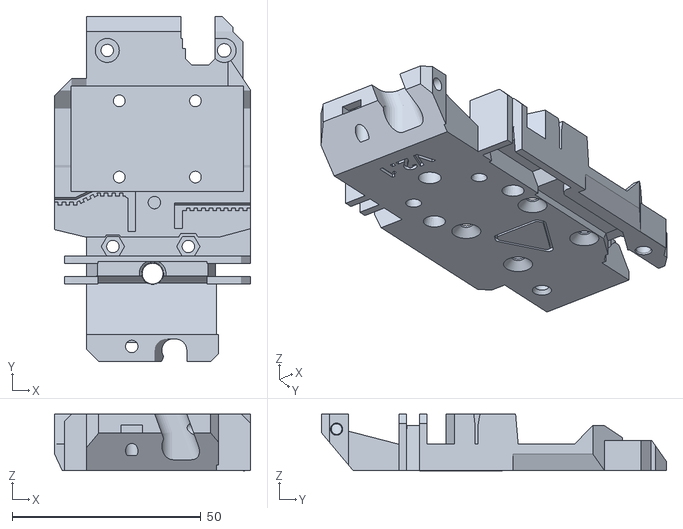
[picture p65: CAD file, 2021-06-09]
STL/X AXIS/EXTRUDERS/VERTEX XL SINGLE/Extruder_x_carriage.stl
52.0 x 91.5 x 15.1
