Vertex3dPrinters/VERTEX-XL/STL/Y AXIS/Y_tensioner_body.stl

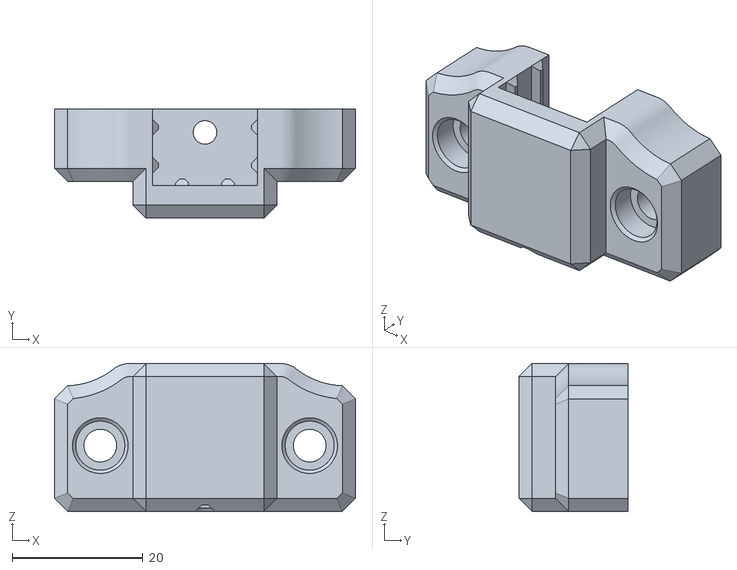
[picture p66: CAD file, 2022-01-25]
STL/Y AXIS/Y_tensioner_body.stl
46.0 x 16.7 x 22.6
