Vertex3dPrinters/VERTEX-XL/STEP/ACCESORIES/2020_sides_cover.step

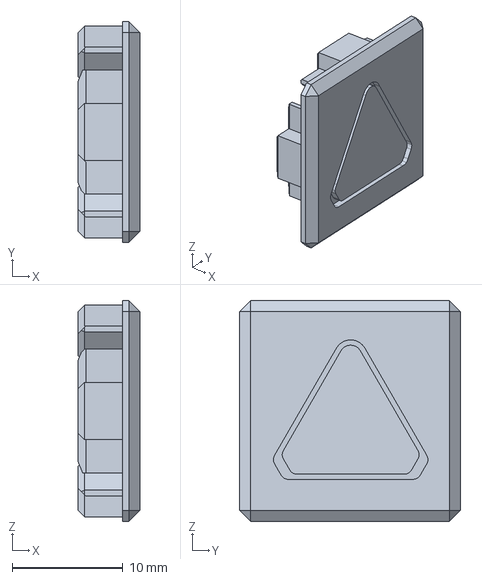
[picture p67: CAD file, 2021-05-15]
STEP/ACCESORIES/2020_sides_cover.step
5.60 x 20.0 x 20.0 mm
