Vertex3dPrinters/VERTEX-XL/STEP/X AXIS/EXTRUDERS/extruder-cover.step

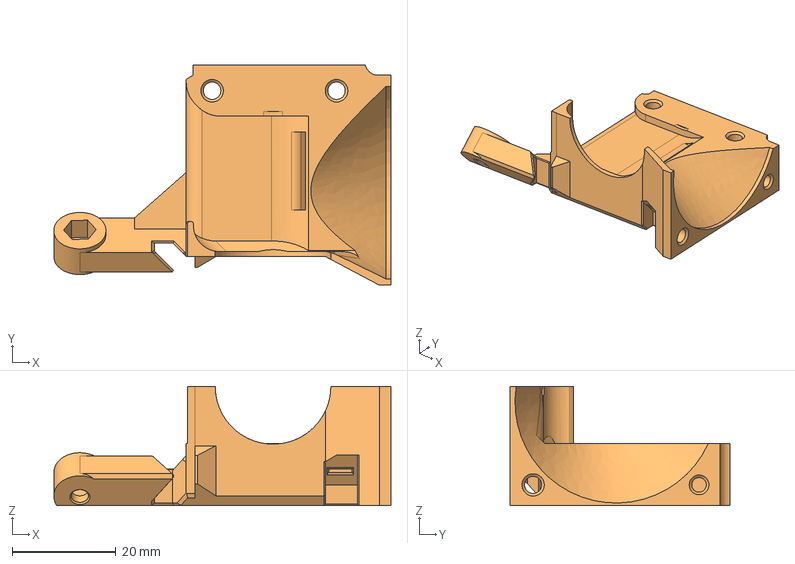
[picture p68: CAD file, 2021-09-25]
STEP/X AXIS/EXTRUDERS/extruder-cover.step
65.0 x 42.5 x 23.0 mm
