Vertex3dPrinters/VERTEX-XL/STEP/Y AXIS/Y_CARRIAGE v1.step

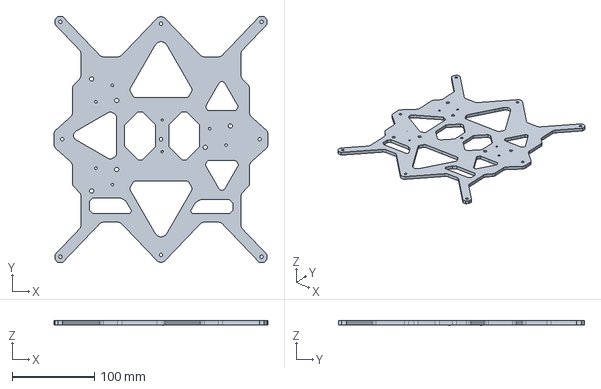
[picture p69: CAD file, 2021-09-25]
STEP/Y AXIS/Y_CARRIAGE v1.step
260.0 x 299.2 x 5.50 mm
