Vertex3dPrinters/VERTEX-XL/STL/X AXIS/EXTRUDERS/VERTEX XL MMU2S+/MOD-extruder-fs-lever.stl

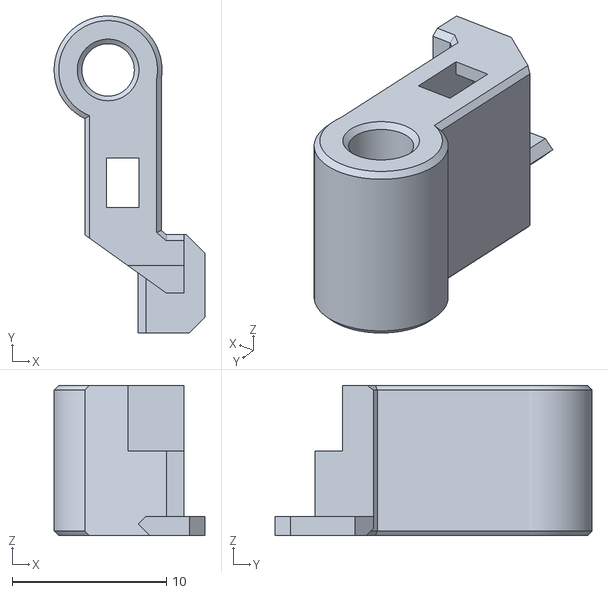
[picture p70: CAD file, 2021-04-14]
STL/X AXIS/EXTRUDERS/VERTEX XL MMU2S+/MOD-extruder-fs-lever.stl
9.77 x 20.6 x 9.75
