Vertex3dPrinters/VERTEX-XL/STL/X AXIS/EXTRUDERS/VERTEX XL SINGLE/Extruder_print-fan-support.stl

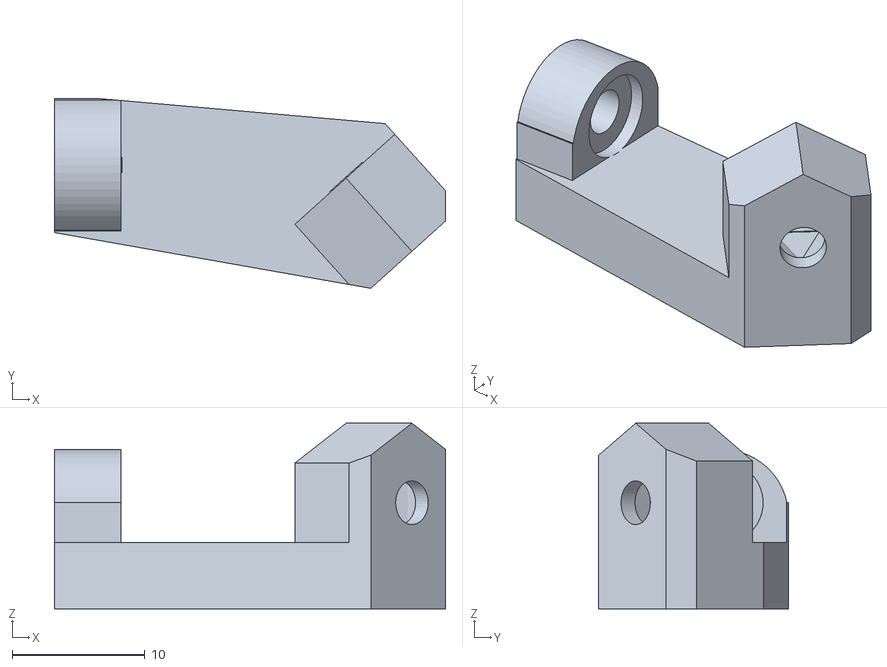
[picture p71: CAD file, 2021-01-04]
STL/X AXIS/EXTRUDERS/VERTEX XL SINGLE/Extruder_print-fan-support.stl
29.5 x 14.3 x 14.0
