Vertex3dPrinters/VERTEX-XL/STL/Y AXIS/Y_motor_holder.stl

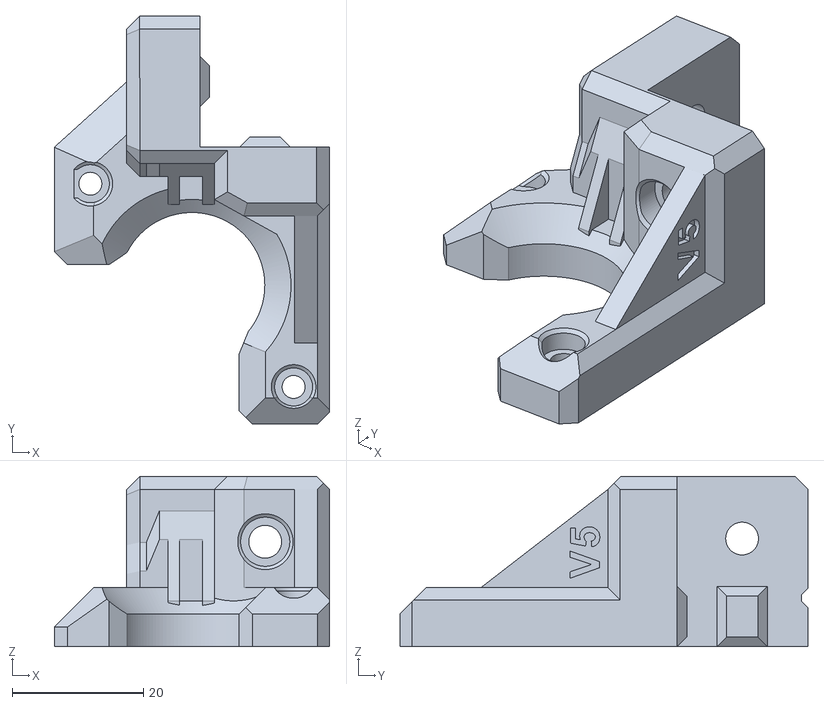
[picture p72: CAD file, 2022-01-25]
STL/Y AXIS/Y_motor_holder.stl
42.0 x 62.2 x 26.0
