Vertex3dPrinters/VERTEX-XL/STEP/ACCESORIES/2020_LCD_cable_clip.step

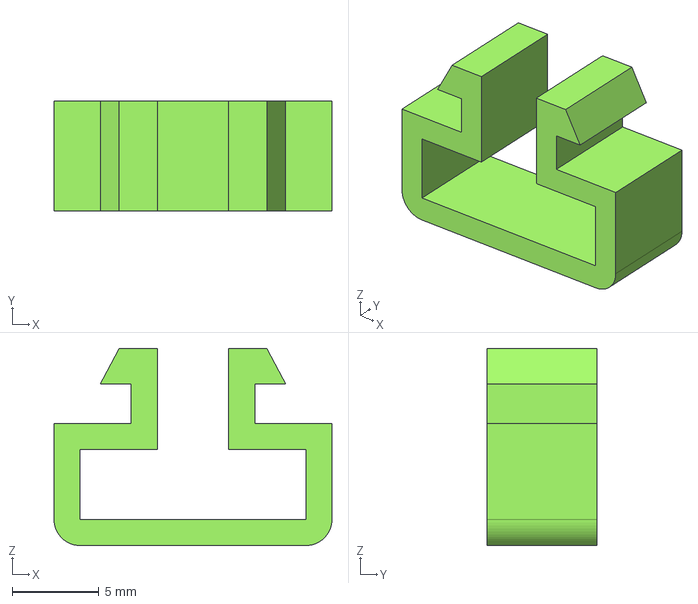
[picture p73: CAD file, 2021-05-15]
STEP/ACCESORIES/2020_LCD_cable_clip.step
16.0 x 6.35 x 11.3 mm
