Vertex3dPrinters/VERTEX-XL/STEP/X AXIS/EXTRUDERS/fan-shroud.step

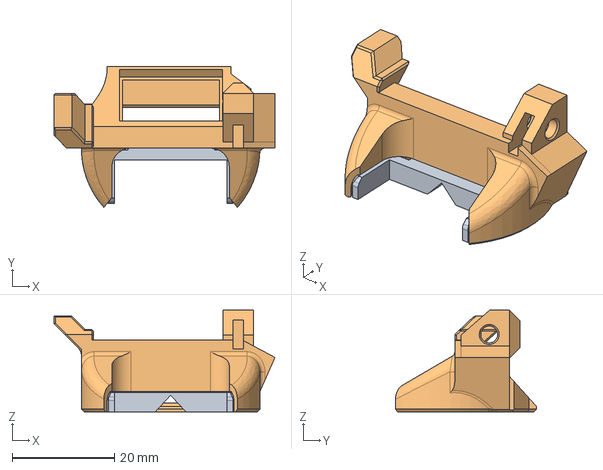
[picture p74: CAD file, 2021-09-25]
STEP/X AXIS/EXTRUDERS/fan-shroud.step
43.3 x 27.6 x 19.9 mm
