Vertex3dPrinters/VERTEX-XL/STL/ACCESORIES/x6_2020_corner.stl

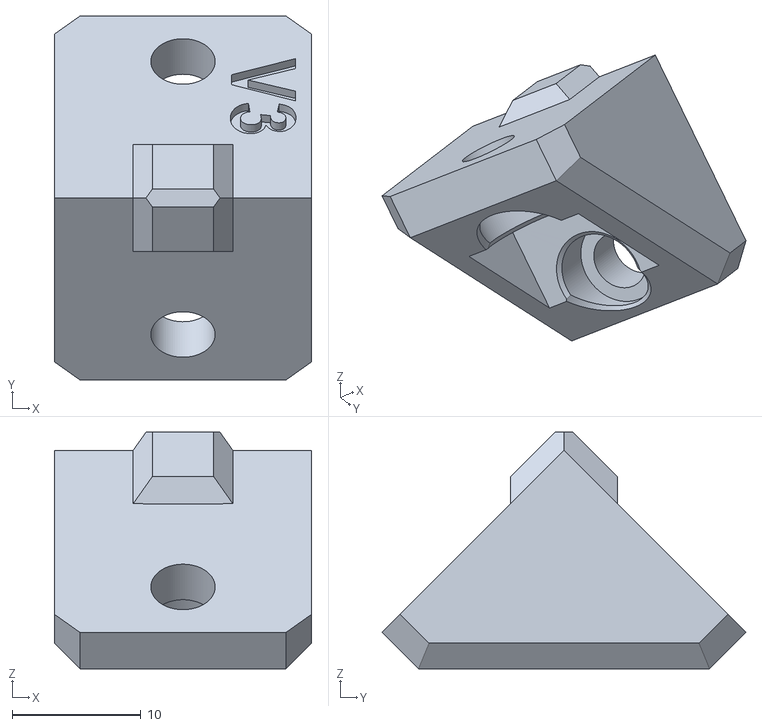
[picture p75: CAD file, 2022-01-25]
STL/ACCESORIES/x6_2020_corner.stl
20.0 x 28.3 x 18.4
