Vertex3dPrinters/VERTEX-XL/STL/Y AXIS/Y_tensioner.stl

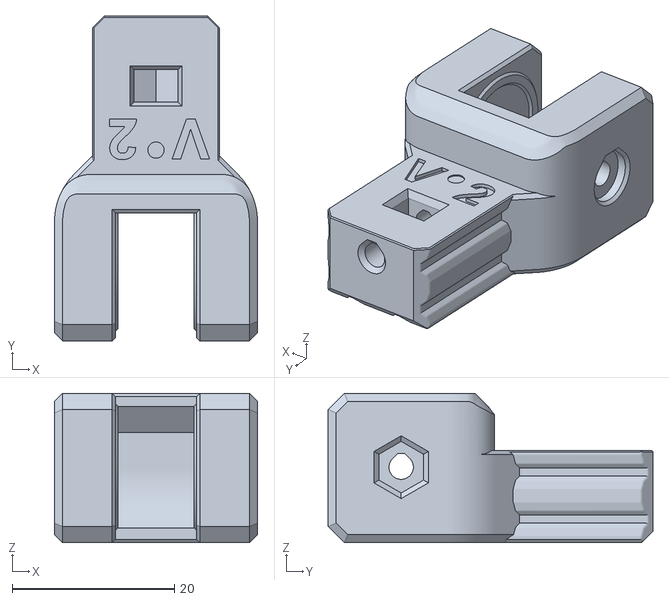
[picture p76: CAD file, 2021-05-22]
STL/Y AXIS/Y_tensioner.stl
25.0 x 40.0 x 18.4
