Vertex3dPrinters/VERTEX-XL/STEP/ACCESORIES/RAMBO_box_spacer.step

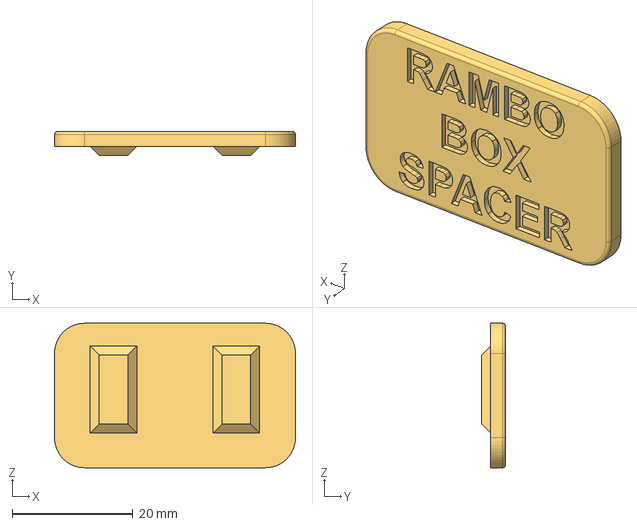
[picture p77: CAD file, 2021-05-15]
STEP/ACCESORIES/RAMBO_box_spacer.step
40.0 x 4.00 x 24.0 mm
