Vertex3dPrinters/VERTEX-XL/STEP/X AXIS/EXTRUDERS/extruder-idler.step

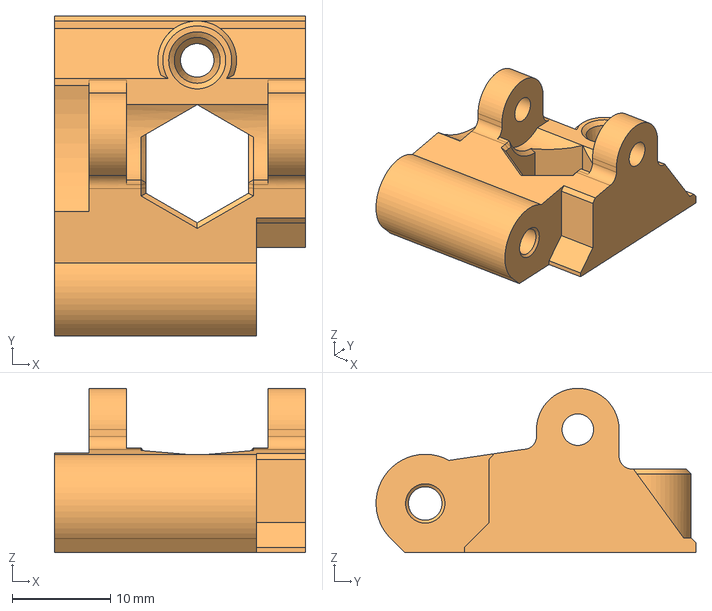
[picture p78: CAD file, 2021-09-25]
STEP/X AXIS/EXTRUDERS/extruder-idler.step
25.5 x 32.5 x 16.7 mm
