Vertex3dPrinters/VERTEX-XL/STEP/ACCESORIES/Y_linear_rails_spacers.step

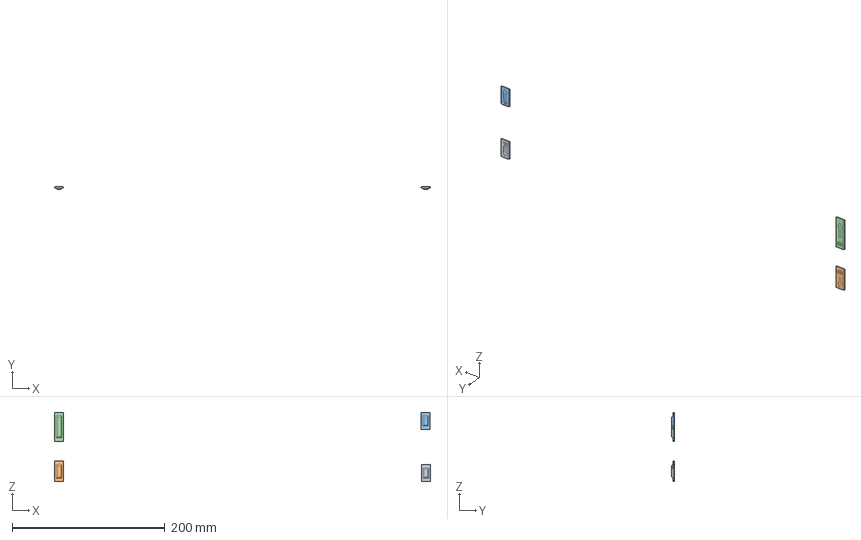
[picture p79: CAD file, 2021-05-15]
STEP/ACCESORIES/Y_linear_rails_spacers.step
492.0 x 3.50 x 90.9 mm
