Vertex3dPrinters/VERTEX-XL/STL/ACCESORIES/x4_rubber_feet.stl

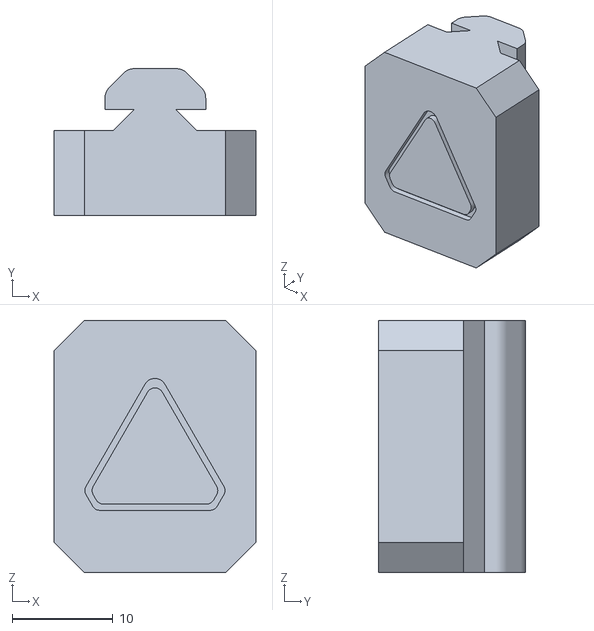
[picture p80: CAD file, 2021-05-29]
STL/ACCESORIES/x4_rubber_feet.stl
20.0 x 14.6 x 25.0
