Vertex3dPrinters/VERTEX-XL/STL/ACCESORIES/2020_MMU_XL_holder.stl

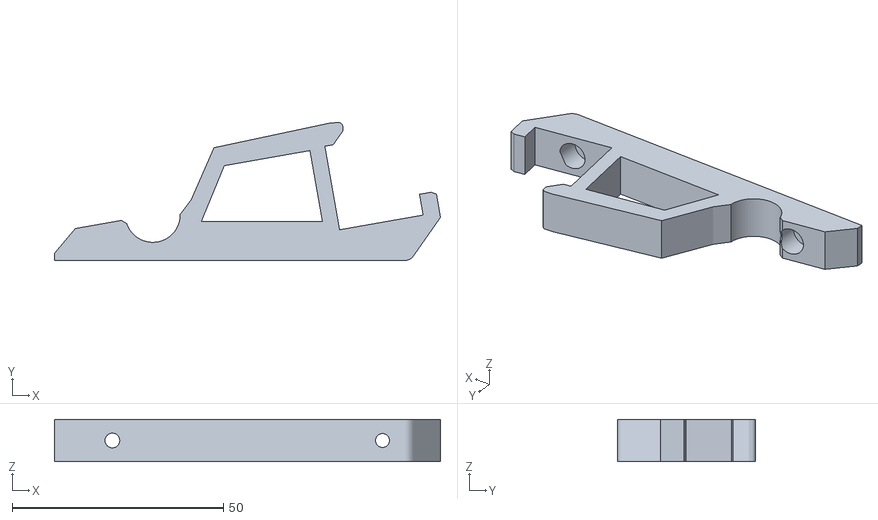
[picture p81: CAD file, 2021-05-26]
STL/ACCESORIES/2020_MMU_XL_holder.stl
91.5 x 32.7 x 10.0
