Vertex3dPrinters/VERTEX-XL/STL/X AXIS/EXTRUDERS/VERTEX XL SINGLE/Extruder_cable_holder.stl

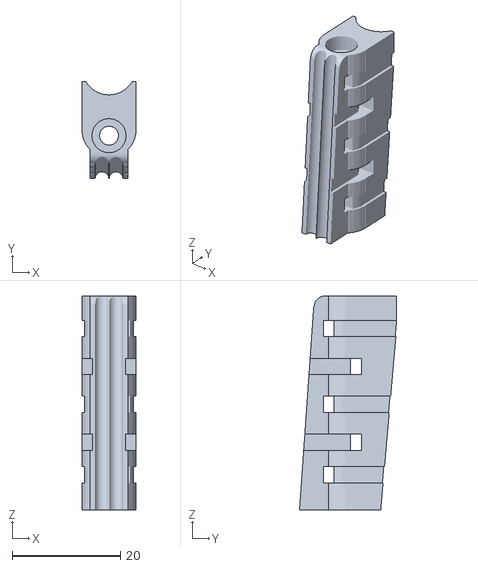
[picture p82: CAD file, 2021-01-04]
STL/X AXIS/EXTRUDERS/VERTEX XL SINGLE/Extruder_cable_holder.stl
10.0 x 17.9 x 39.5
