Vertex3dPrinters/VERTEX-XL/STL/X AXIS/EXTRUDERS/VERTEX XL SINGLE/Extruder_cover.stl

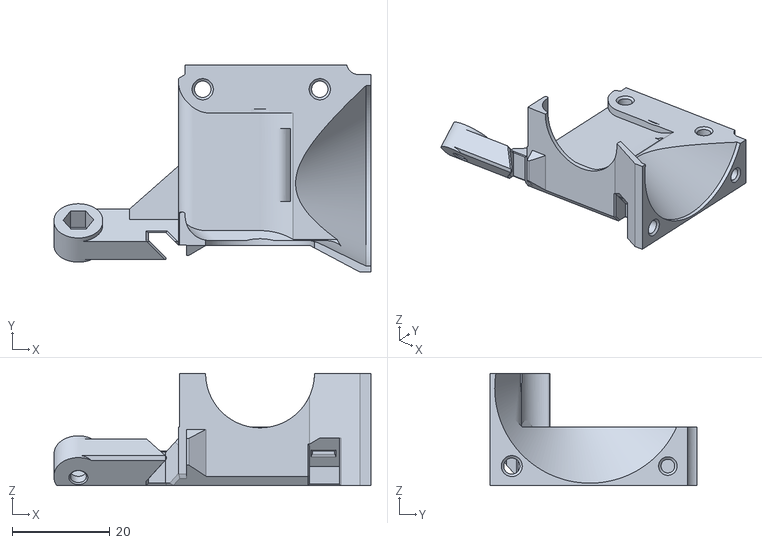
[picture p83: CAD file, 2021-01-04]
STL/X AXIS/EXTRUDERS/VERTEX XL SINGLE/Extruder_cover.stl
65.0 x 42.5 x 23.0
