Vertex3dPrinters/VERTEX-XL/(list of files, cad)

Other CAD files:
STL/X AXIS/EXTRUDERS/VERTEX XL SINGLE/Extruder_body.stl
STL/X AXIS/X AXIS PARTS/VERTEX XL smooth rods1/X_end_motor_idler v2.2.stl
STL/Y AXIS/x4_Y_MGN12_linear_rail_holder.stl
STL/Z AXIS/RAMBO motherboard/Rambo_cover.stl
STL/Z AXIS/Z REINFORCEMENT/Z_bottom_reinforcement_right.stl
STL/Z AXIS/Z_motor_holder_left.stl
STEP/X AXIS/EXTRUDERS/extruder-motor-plate.step
STEP/ACCESORIES/Z_support.step
STEP/Z AXIS/Z_TOP_LEFT.step
STL/X AXIS/EXTRUDERS/VERTEX XL MMU2S+/MOD-extruder-body.stl
STL/Z AXIS/Z REINFORCEMENT/Z_top_reinforcement_right.stl
STL/ACCESORIES/Y_linear_front_right_spacer.stl
STL/ACCESORIES/Z-Y_angle.stl
STEP/Y AXIS/Y_BELT_HOLDER v1.step
STL/X AXIS/EXTRUDERS/VERTEX XL MMU2S+/MOD-fs-cover-M8.stl
STL/X AXIS/EXTRUDERS/VERTEX XL SINGLE/Extruder_fan_shroud.stl
STL/ACCESORIES/Spool_holder_right.stl
STL/X AXIS/EXTRUDERS/VERTEX XL SINGLE/Extruder_fs_lever.stl
STEP/X AXIS/EXTRUDERS/adapter-printer.step
STL/X AXIS/EXTRUDERS/VERTEX XL SINGLE/Extruder_fs_cover.stl
STL/ACCESORIES/x2_2020_extrusion_cover.stl
STL/ACCESORIES/Z_rambo_box_spacer.stl
STL/X AXIS/EXTRUDERS/VERTEX XL SINGLE/Extruder_idler.stl
STL/ACCESORIES/x4_2020_cable_clip.stl
STL/X AXIS/X AXIS PARTS/X_end_idler.stl
STL/X AXIS/X AXIS PARTS/X_end_motor_idler.stl
STL/X AXIS/X AXIS PARTS/X_end_tensioner.stl
STL/Z AXIS/Z_screw_cover.stl
STL/Z AXIS/Z_top_left.stl
STL/Z AXIS/Z_top_right.stl
