Vertex3dPrinters/VERTEX-XL/(commit log)

2020-12-31 Test de commit
2021-01-04 Rev12 XL V2
    [2020_cable_clip.stl, DELTA_PSU_case v2.stl, Extruder_adapter_printer.stl, Extruder_body.stl, Extruder_cable_holder.stl, Extruder_cable_rambo_cover v2.stl, Extruder_cover.stl, Extruder_fan_shroud.stl]
2021-04-14 Screws adjustment
    [Extruder_cable_holder.stl, Extruder_x_carriage v2.stl, Extruder_x_carriage.stl, Extruder_x_carriage_cover v2.stl, Extruder_x_carriage_cover.stl, X_axis_end_idler v2.1.stl, X_axis_end_tensioner v2.1.stl, X_end_idler v2.1.stl]
2021-04-14 Motor hole covered
    [Z_top_left_V2.stl, Z_top_right_V2.stl, Z_top_right_v2.2.stl]
2021-04-14 Folder reorganization
    [Z_top_right_v2.2.stl]
2021-04-14 New knob
    [LCD-knob.stl]
2021-04-14 Deleted parts
    [Extruder_cable_holder.stl, Extruder_x_carriage v2.stl, Extruder_x_carriage.stl, Extruder_x_carriage_cover v2.stl, Extruder_x_carriage_cover.stl, X_axis_end_idler v2.1.stl, X_axis_end_tensioner v2.stl, X_motor_idler v2.2.stl]
2021-04-19 New titles
    [Extruder_adapter_printer.stl, Extruder_body.stl, Extruder_cable_holder.stl, Extruder_cable_rambo_cover.stl, Extruder_cover.stl, Extruder_fan_shroud.stl, Extruder_fs_cover.stl, Extruder_fs_lever.stl]
2021-04-24 New Y axis linear rail mount
    [x4_Y_MGN12_linear_rail_holder.stl]
2021-05-05 New Z-y reinforcement
    [Z-Y_reinforcement_ L_ left.stl, Z-Y_reinforcement_ L_ right.stl]
2021-05-22 New name
    [Y_linear_back_left_spacer.stl, Y_linear_back_right_spacer.stl, Y_linear_front_left_spacer.stl, Y_linear_front_right_spacer.stl]
2021-05-24 MMU2S+ extruder
    [COLOR-1.stl, COLOR-2.stl, Extruder_x_carriage.stl, Extruder_x_carriage_cover.stl, MOD-extruder-body.stl, MOD-extruder-fs-lever.stl, MOD-extruder-idler.stl, MOD-extruder-motor-plate.stl]
2021-05-29 stl orientation
    [x4_rubber_feet.stl]
2021-05-30 New spool holder
    [Spool_holder_right.stl]
2021-05-30 X carriage adjustments
    [Extruder_x_carriage.stl]
2021-05-30 X carriage cover adjustments
    [Extruder_x_carriage_cover.stl]
2021-05-30 Z motor holder part adjustment
    [Z_motor_holder_left.stl, Z_motor_holder_right.stl]
2021-06-05 less plastic
    [X_end_idler.stl, X_end_motor_idler.stl]
2021-06-07 m3x14mm X motor screws
    [X_end_motor_idler.stl]
2021-06-07 Y linear rails spacers update
    [Y_linear_back_left_spacer.stl, Y_linear_back_right_spacer.stl, Y_linear_front_left_spacer.stl, Y_linear_front_right_spacer.stl]
2021-06-07 New LCD holders
    [LCD_Support A.stl, LCD_Support B.stl]
2021-06-09 new parts
    [Z_motor_holder_left.stl, Z_motor_holder_right.stl]
2021-06-18 Hole for LCD cables while installing the LCD in the top of the printer.
    [Rambo_cover.stl]
2021-07-26 LCD cables top mount
    [Rambo_case.stl, Rambo_cover.stl]
2021-08-11 New version
    [Z_bottom_left.stl, Z_bottom_reinforcement_left.stl, Z_bottom_reinforcement_right.stl, Z_bottom_right.stl, Z_top_left.stl, Z_top_reinforcement_left.stl, Z_top_reinforcement_right.stl, Z_top_right.stl]
2021-08-20 New design
    [LCD_cover.stl, LCD_cover_main_color.stl, LCD_cover_second_color.stl, LCD_cover_x_third_color.stl]
2021-08-24 new part
    [Extruder_x_carriage_cover.stl]
2021-09-09 Added all step files of the VERTEX XL
    [ALUMINIUM_PROFILES.step, Heatbed_cover.step, LCD_SINGLE.step, LCD_Supports.step, PSU.step, RAMBO_BOX.step, RUBBER_FEET.step, SPOOL_HOLDER.step]
2021-09-20 Draft of the spanish assembly guide
2021-09-21 MErged with Z axis
2021-09-24 Update of the assembly guide
2021-09-25 Nothing new
    [Extruder_body.stl, Extruder_motor_plate.stl]
2021-09-25 extruder steps
    [extruder-body.step, extruder-cover.step, extruder-idler.step, extruder-motor-plate.step, fan-shroud.step, fs-cover.step, fs-lever.step, print-fan-support.step]
2021-09-25 moving folder
    [Heatbed_cover.step, Y_BELT_HOLDER v1.step, Y_CARRIAGE v1.step, Y_LINEAR_RODS_HOLDERS.step, Y_MOTOR_HOLDER v1.step, Y_TENSIONER v1.step]
2021-09-27 adjustment 6.1
    [Extruder_body.stl, extruder-body.step]
2021-09-27 Actualización de la guía de montaje
2021-11-21 Y carriage and heatbed STL and STEPS
    [300x320mm HEATBED.step, 300x320mmHeatbed.stl, Y_CARRIAGE.stl]
2022-01-25 V3 Bigger holes
    [Extruder_cable_rambo_cover.stl, Heatbed_cable_rambo_cover.stl, LCD_Support A.stl, LCD_Support B.stl, PSU_body.stl, PSU_cover.stl, PSU_top_holder.stl, PSU_top_holder_pin.stl]
2022-01-25 Bigger holes V4
    [Z_motor_holder_left.stl, Z_motor_holder_right.stl]
2022-02-05 Create VERTEX XL ASSEMBLY GUIDE V0.97 ENGLISH.pdf
2022-02-05 Update VERTEX XL ASSEMBLY GUIDE V0.97 ENGLISH.pdf
2022-02-14 Assembly guide v1.1
2022-02-16 Create XL PCB.png
2022-02-24 Holes adjustments
    [PSU_top_holder_pin.stl]
2022-06-07 v4 top supports
    [Z_bottom_reinforcement_right.stl, Z_top_left.stl, Z_top_reinforcement_left.stl, Z_top_reinforcement_right.stl, Z_top_right.stl]
2022-06-07 no changes
    [Z_bottom_reinforcement_left.stl, Z_bottom_reinforcement_right.stl]
2022-12-13 PS model uploaded
    [xl_bed.stl]
